Alon-Tal/WiFi-Alarm/Presentation/מצגת.pdf

# Wi-Fi אזעקת

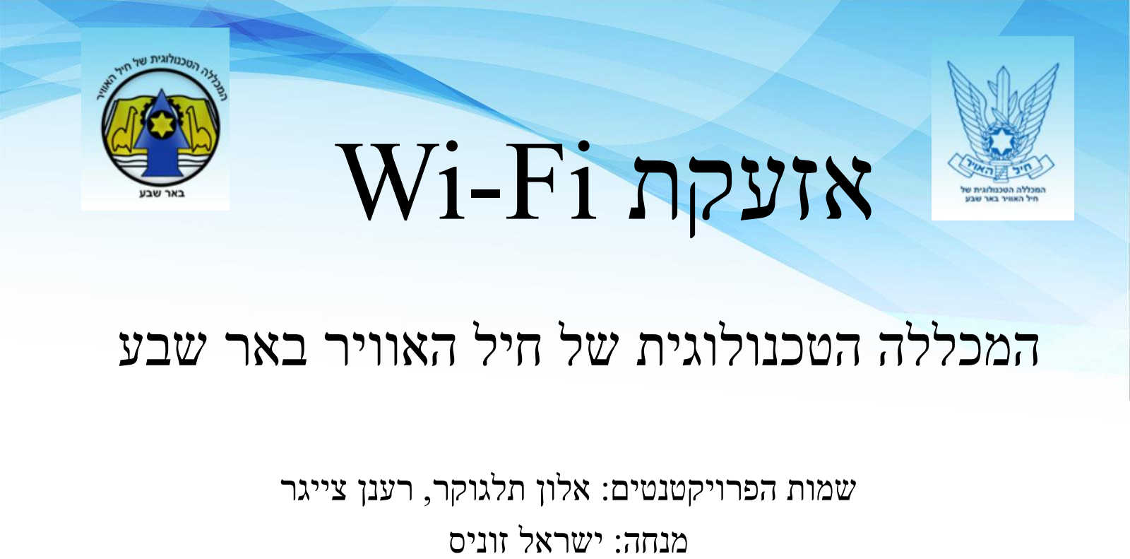
[picture p1: page 1]

שמות הפרויקטנטים: אלון תלגוקר, רענן צייגר מנחה: ישראל זוניס

# המכללה הטכנולוגית של חיל האוויר באר שבע

# תקציר:

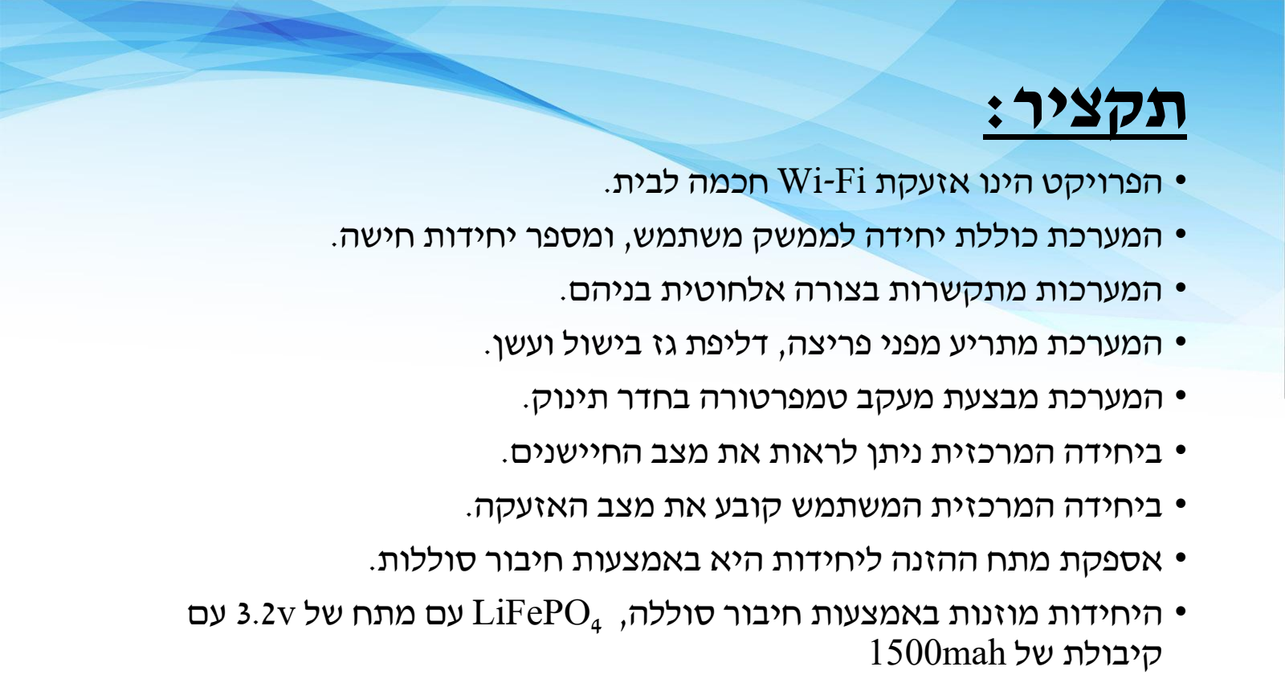
[picture p2: page 2]

- הפרויקט הינו אזעקת Fi-Wi חכמה לבית.
- המערכת כוללת יחידה לממשק משתמש, ומספר יחידות חישה.
- המערכות מתקשרות בצורה אלחוטית בניהם.
- המערכת מתריע מפני פריצה, דליפת גז בישול ועשן.
- המערכת מבצעת מעקב טמפרטורה בחדר תינוק.
- ביחידה המרכזית ניתן לראות את מצב החיישנים.
- ביחידה המרכזית המשתמש קובע את מצב האזעקה.
- אספקת מתח ההזנה ליחידות היא באמצעות חיבור סוללות.
- היחידות מוזנות באמצעות חיבור סוללה, LiFePO
4

עם מתח של v3.2 עם
קיבולת של mah1500

# דיאגרמת מלבנים של המערכת:

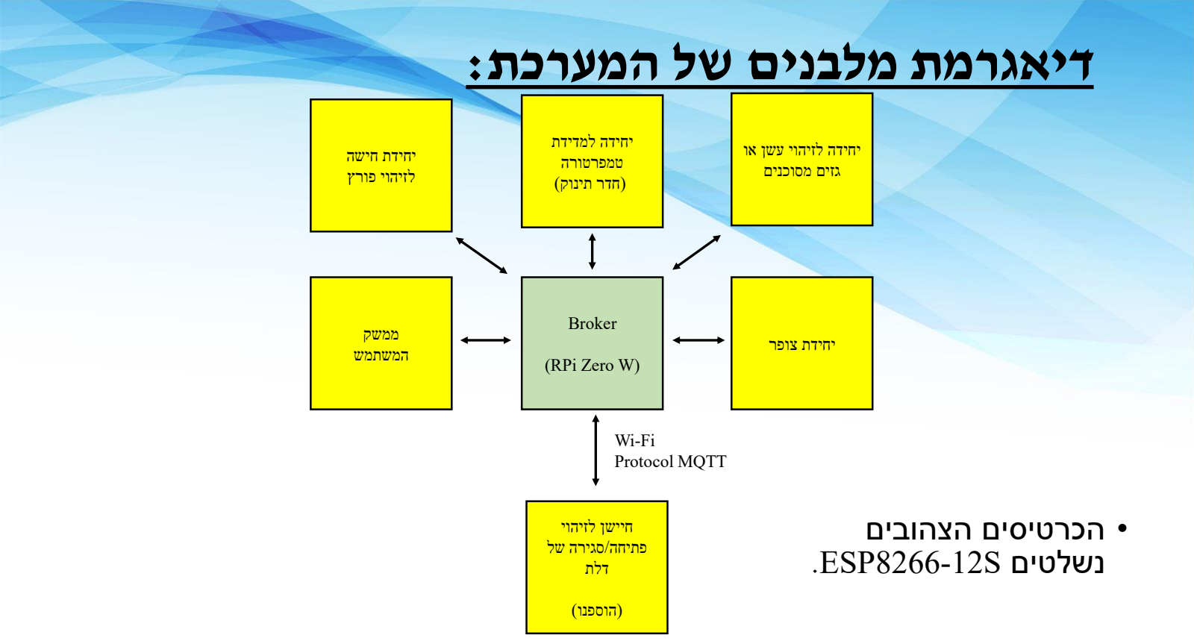
[picture p3: page 3]

- הכרטיסים הצהובים
.ESP8266-12S | נשלטים

יחידת חישה
לזיהוי פורץ

יחידה למדידת
טמפרטורה
)חדר תינוק(

יחידה לזיהוי עשן או
גזים מסוכנים

Broker

(RPi Zero W)

ממשק
המשתמש

יחידת צופר

חיישן לזיהוי
פתיחה/סגירה של
דלת

)הוספנו(

Wi-Fi
Protocol MQTT

## ממשק המשתמש-דיאגרמת בלוקים

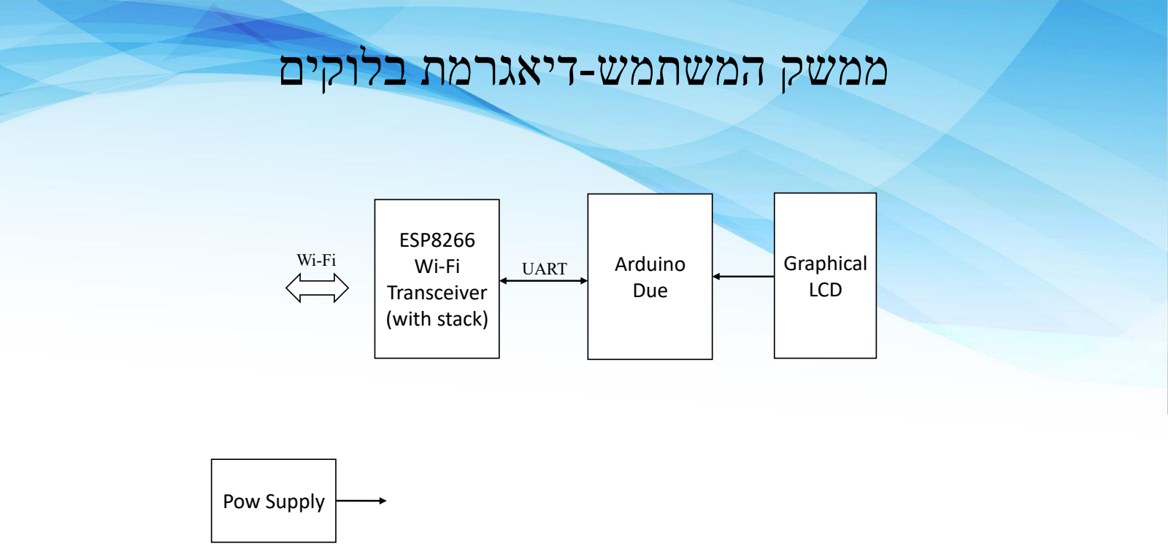
[picture p4: page 4]

Arduino
Due

Graphical
LCD

UART

ESP8266
Wi-Fi
Transceiver
(with stack)

Pow Supply

Wi-Fi

## יחידת חישה-דיאגרמת בלוקים

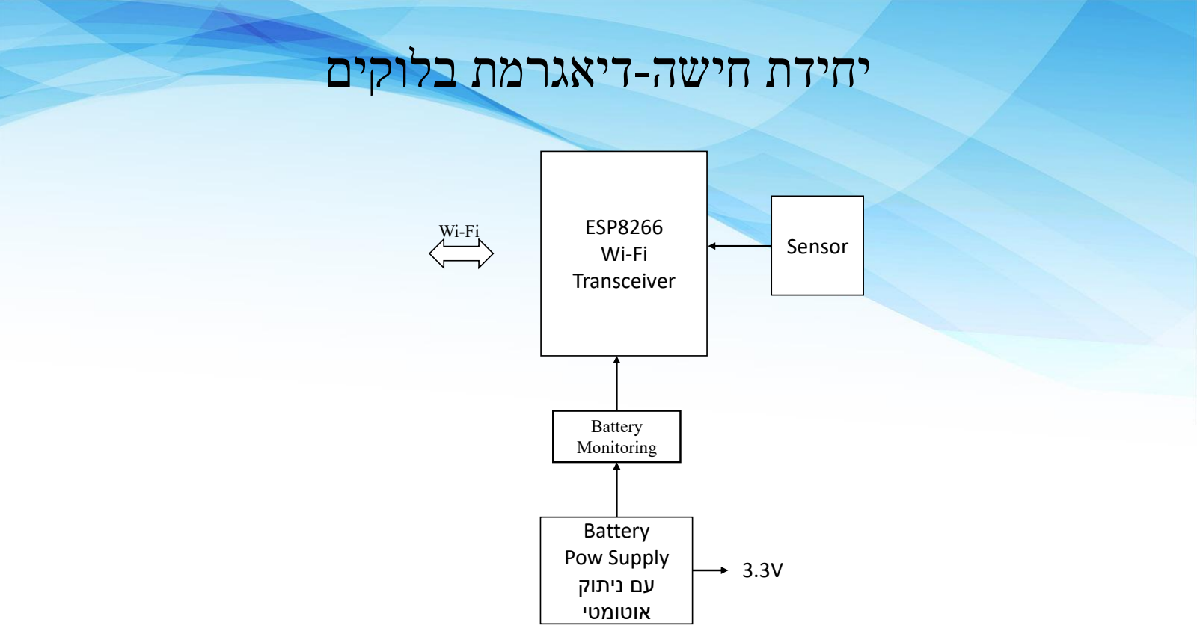
[picture p5: page 5]

3.3V

Sensor

ESP8266
Wi-Fi
Transceiver

Wi-Fi

Battery
Pow Supply
עם ניתוק
אוטומטי

Battery
Monitoring

# פרוטוקול MQTT:

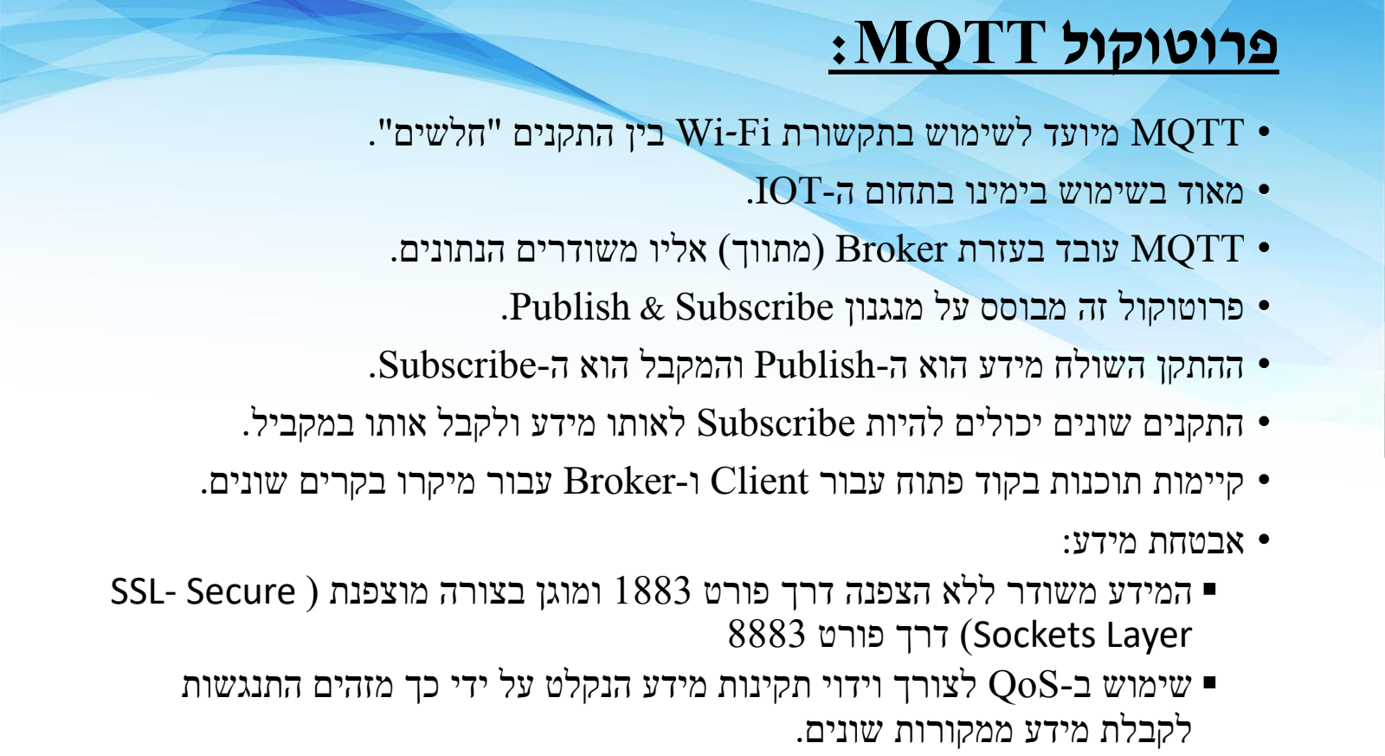
[picture p6: page 6]

- MQTT מיועד לשימוש בתקשורת Fi-Wi בין התקנים "חלשים".
- מאוד בשימוש בימינו בתחום ה-IOT.
- MQTT עובד בעזרת Broker( מתווך( אליו משודרים הנתונים.
- פרוטוקול זה מבוסס על מנגנון Subscribe & Publish.
- ההתקן השולח מידע הוא ה-Publish והמקבל הוא ה-Subscribe.
- התקנים שונים יכולים להיות Subscribe לאותו מידע ולקבל אותו במקביל.
- קיימות תוכנות בקוד פתוח עבור Client ו-Broker עבור מיקרו בקרים שונים.
- אבטחת מידע:
- המידע משודר ללא הצפנה דרך פורט 1883 ומוגן בצורה מוצפנת ) Secure -SSL Layer Sockets )דרך פורט 8883
- שימוש ב-QoS לצורך וידוי תקינות מידע הנקלט על ידי כך מזהים התנגשות לקבלת מידע ממקורות שונים.

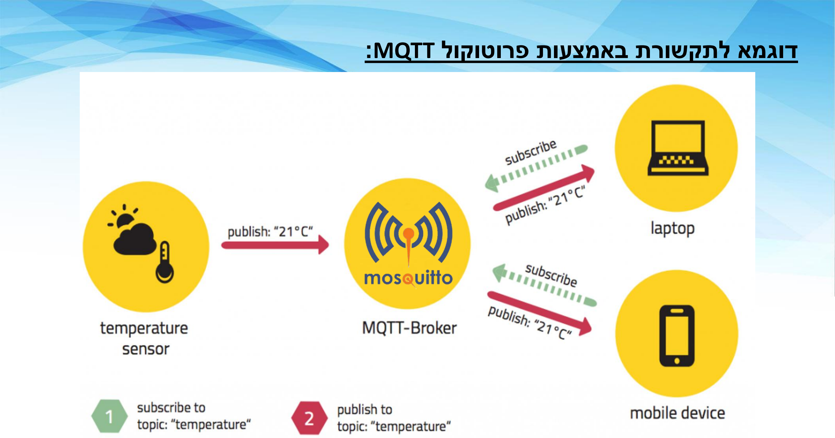
[picture p7: page 7]

דוגמא לתקשורת באמצעות פרוטוקול MQTT:

## :ESP8266 12-S בקר

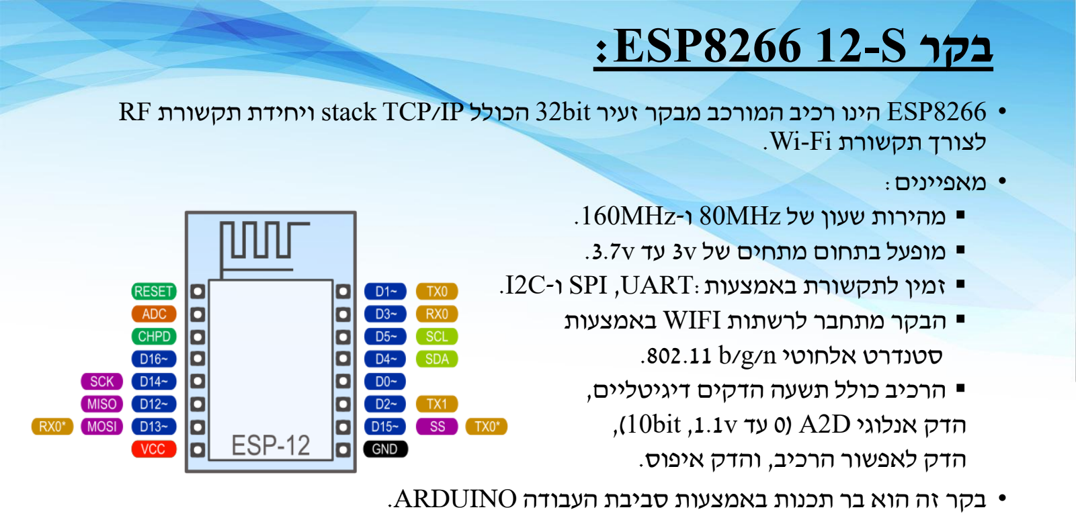
[picture p8: page 8]

- 8266ESP הינו רכיב המורכב מבקר זעיר bit32 הכולל IP/TCP stack ויחידת תקשורת RF לצורך תקשורת Fi-Wi.
- מאפיינים:
- מהירות שעון של MHz80 ו-MHz.160
- מופעל בתחום מתחים של v3 עד v.3.7
- זמין לתקשורת באמצעות:UART, SPI ו-C2I.
- הבקר מתחבר לרשתות WIFI באמצעות
.802.11 b/g/n | אלחוטי | סטנדרט
- הרכיב כולל תשעה הדקים דיגיטליים,
,)10bit ,1.1v עד 0 )A2D | אנלוגי | הדק
הדק לאפשור הרכיב, והדק איפוס.
- בקר זה הוא בר תכנות באמצעות סביבת העבודה ARDUINO.
