Alon-Tal/WiFi-Alarm/Book/ספר גרסא הסופית.pdf

# פרוייקט WiFi Alarm

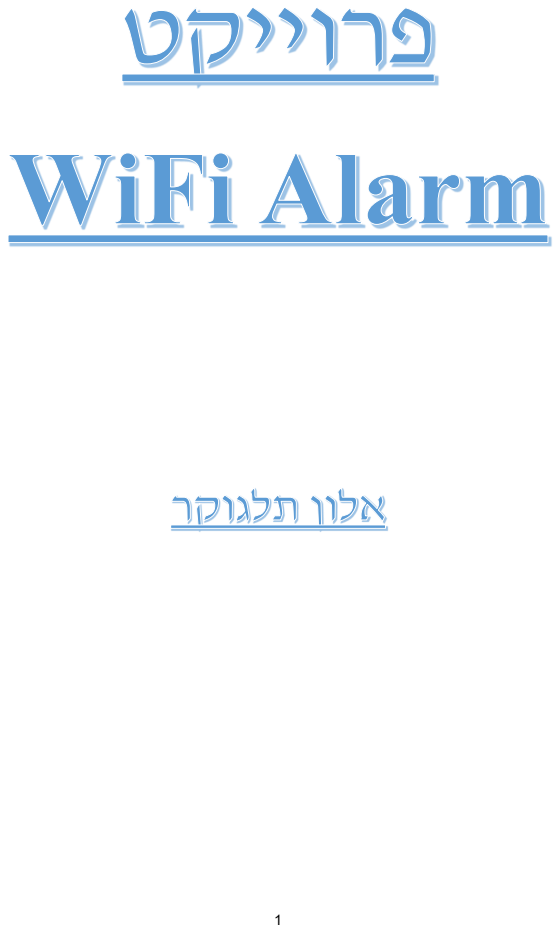
[picture p9: page 1]

### תקציר הפרויקט:

מטרת הפרויקט הינה תכנון ובניית אזעקה בעלת יכולות חישה רבות.

המערכת בנויה לפי מודל חדיש של מערכות אינטרנט של חפצים- IOT. היא כוללת יחידה לממשק עם המשתמש ומספר יחידות חישה. כל היחידות מקושרות בתקשורת Fi-Wi עם יחידה מרכזית.

המערכת מתריעה מפני פריצה לבית, דליפת גז בישול, דליפת עשן.

פונקציה נוספת של המערכת הינה מעקב טמפרטורה של חדר תינוק עם התראה מפני טמפרטורה גבוהה או נמוכה מידי המסכנת את התינוק.

כיוון שהעברת התקשורת בין היחידות מתבצעת באמצעות Fi-Wi אין צורך בהעברת כבלים בבית, יש רק לספק ליחידות מתח הזנה על ידי חיבור סולל ה מתאימה .

על ידי שימוש ביחידה המרכזית המשתמש יוכל לראות את מצב החיישנים ואחוזי הסוללות ובנוסף יוכל לקבוע את מצב י האזעקה.

זיהוי המשתמש היא על ידי תג זיהוי )RFID).

המערכת מתוכננת בצורה מודולארית וניתן להוסיף לה יחידות חישה נוספות בצורה יחסית קלה )יש רק להוסיף קוד מתאים ליחידת הממשק למשתמש(.

המערכת שולחת התראות לפלאפונים בעלי מערכת הפעלה Android.

תוכן עניינים -
פרק 1 מבוא 5 |
1.1 מבוא: 6 |
1.2 מפרט טכני: 7 |
1.3 רשימת מרכיבים: 8 |
1.4 הוראות הפעלה9 | :
פרק 2 דיאגרמת בלוקים 10 |
2.1 דיאגרמת בלוקים: 11 |
פרק 3 סכמה חשמלית 13 |
3.1 יחידת ממשק המשתמש 14 |
3.2 תרשים מלבנים עקרוני של יחידת החישה 17 |
פרק 4 תרשים זרימה 25 |
4.1 תרשים זרימה של התוכנית הראשית ביחידת ממשק המשתמש26 | :
4.2 תרשים זרימה של התוכנית ב8266-ESP ביחידת ממשק המשתמש35 | :
4.3 תרשים זרימה של התוכנית ב8266-ESP ביחידות החישה37 | :
פרק 5 תוכנה 39 |
5.1 התוכנה שצרובה ליחידת ממשק המשתמש: 40 |
טבלת פונקציות43 | :
5.2 התוכנית שצרובה ל 8266-ESP ביחידת ממשק המשתמש47 | :
טבלת פונקציות48 | :
5.3 התוכנה שצרובה ל- 8266esp שמחובר לחיישן גז: 49 |
טבלת פונקציות50 | :
פרק 6 זיווד 51 |
פרק 7 סיכום 54 |
7.1 פרק תקלות במהלך העבודה55 | :
7.2 פרק סיכום והסקת מסקנות: 55 |
הצעות לפיתוח עתידי: 55 |
פרק 8 ביבליוגרפיה 56 |
פרק 9 נספחים 58 |
59 | :Arduino Due 9.1
9.2 תצוגה גרפית עם מסך מגע60 | :
9.3 צופר BUZZER: 61 |
9.4 שעון זמן אמת 1302DS RTC: 62 |
9.5 חיישן זיהוי צ'יפים RFID: 63 |
65 | :ESP8266-12S | בקר | 9.6
66 | :AT24C64 (EEPROM ( | זיכרון | יחידת | 9.7
9.8 גלאי גז בישול 6MQ וגלאי עשן 135MQ: 68 |
9.9 סוללות 4LiFePO69 | :
9.10 ממיר מתח ממותג )Up Step (BOOST70 | :
9.11 חיישן טמפרטורה 20B18DS71 | :
9.12 פרוטוקול תקשורת WIRE-ONE: 73 |
9.13 פרוטוקול SPI76 | :
78 | :I2C | פרוטוקול | 9.14
9.15 פרוטוקול UART81 | :
9.16 פרוטוקול MQTT: 83 |
פרק חישובים: 93 |

רשימת טבלאות:

טבלה 1 - טבלת החיבורים של ה-DUE ARDUINO16 | :
טבלה 2 - טבלת החיבורים של בקר ה8266-ESP 19 |
טבלה 3 - טבלת הפונקציות בתוכנית ביחידת ממשק המשתמש43 |
טבלה 4 - טבלת פונקציות של ה8266-ESP ביחידת ממשק המשתמש 48 |
טבלה 5 - טבלת פונקציות של אחת מיחידות החישה 50 |

רשימת איורים:

איור 1 - דיאגרמת מלבנים של הפרוייקט 11 |
איור 2 - דיאגרמת בלוקים של יחידת ממשק המשתמש 14 |
איור 3 - סכמה חשמלית של יחידת ממשק המשתמש 15 |
איור 4 - דיאגרמת בלוקים של יחידת החישה 17 |
איור 5 - תרשים חשמלי של חיישני הגז והעשן 18 |
איור 6 - תרשים חשמלי עקרוני של החיישנים הדיגיטליים. 21 |
איור 7 - תרשים חשמלי של ה-Supply Power23 |
איור 8 - ממשק למשתמש 52 |
איור 9 - חיישני החישה 53 |
59 | Arduino Due -10 איור
איור 11 - תצוגה גרפית 60 |
איור 12 - תיאור של מסך התנגדותי 60 |
איור 13 - יחידת הצופר 61 |
62 | RTC DS1302 - 14 איור
איור 15 - קורא צ'יפים וצ'יפ63 |
איור 16 - 8266ESP65 |
איור 17 - יחידת הזיכרון 66 |
איור -18 חיישן גז וחיישן עשן 68 |
איור 19 - סוללות 69 |
איור 20 - ממיר מתח ממותג70 |
איור 21 - חיישן טמפרטורה 71 |
איור 22 - תיאור תדרי הגביש72 |
איור 23 - 20B18DS אופן שידור 73 |
איור 24 - חיבור רכיבים בתקשורת SPI 76 |
איור 25 - שידור 56x0 בתקשורת טורית 82 |
איור 26 - מבנה עקרוני של תקשורת 84 |
איור 27 - מודל 4 השכבות 85 |
איור 28 - תיאור חיבור אל ה-Broker 86 |
איור 29 - תיאור הנושאים 87 |
איור 31 - איכות שירות 1 90 |
איור 32 - איכות שירות 2 91 |
איור 33 - שרטוט השמיט ממעגל המיתוג האלקטרוני שבאיור 93 | 3.6
איור 34 - רוחב החשל 93 |

# פרק 1 מבוא

### 1.1 מבוא:

בפרויקט זה תכננו ובנינו מערכת אזעקה לבית. המערכת תתריע מפני פריצה לבית, דליפת גז בישול, גילוי שריפה, ותציג את הטמפרטורה בחדר נבחר.
המערכת מורכבת ממספר כרטיסים: כרטיס ממשק משתמש, וכרטיסי חישה וצופר. בין הכרטיסים מתקיימת תקשורת Fi-Wi לפי מודל הנפוץ במערכות IOT ( Internet Things Of). לפי מודל זה המערכת מורכבת מיחידות שונות שמתקשרות עם היחידה המרכזית המכונה Broker. היחידות השונות יכולות לשלוח מידע ל-Broker )Publisher )או להירשם לצורך קבלת נתונים מה -Broker( Subscribe). בין היחידות תקשורת לפי פרוטוקול MQTT( מוסבר בנספח( פרוטוקול זה נפוץ יותר מפרוטוקול HTTP במערכות IOT ובמערכות מנוהלות באמצעות מיקרובקרים "חלשים".
ה-Broker ממומש באמצעות כרטיס W-Zero Pi Raspberry בעל מערכת הפעלה Raspbian-Linux ומריץ תוכנה Mosquitto Eclipse שהיא תוכנת Broker בקוד פתוח.
כל שאר הכרטיסים נשלטים באמצעות כרטיס מיקרו בקר S8266-12ESP. זהו

מיקרו בקר בעל 32 סיביות, ובעל ליבה לתקשורת Fi-Wi כולל Stack IP/TCP. יחידת הממשק למשתמש כוללת צג מגע שנותנת למשתמש אפשרות נוחה ל הקליד הוראות הפעלה ולראות את המידע של החיישנים השונים שבבית. כרטיסי יחידת החישה מזהים שינוי קריטי באחד מהחיישנים בבית ומפעילה צופר. המערכת שולחת התראות לפלאפונים בעלי מערכת הפעלה Android.

### 1.2 מפרט טכני:

- אזעקה לבית חכם
- גילוי פריצה לדירה על ידי שימוש בחיישן נפח ופתיחת דלת.
- גילוי עשן בדירה, גילוי דליפת גז בישול.
- התראה מפני טמפרטורה גבוהה או נמוכה בחדר תינוק.
- תכנון אזעקה באמצעות מסך מגע.
- תקשורת Fi-Wi( פרוטוקול MQTT )בין היחידות השונות.
- כל אחת מהיחידות מוזנת מסוללת ליתיום דור חדש )4LiFePO), זמן בין הטעינות מותנה בקיבול הסוללה ) mah).

### 1.3 רשימת מרכיבים:

AT91SAM3X8E | בקר | מיקרו | בתוכו | הכוללת | ARDUINO DUE | כרטיס | •
ESP8266-12S | בקר | •
- חיישן עשן 135MQ
- חיישן גז בישול 6MQ
AT24c64 EEPROM | זיכרון | •
- חיישן תנועה 501SR-HC
CD74HC4053 | בורר | •
- חיישן טמפרטורה 20B18DS
- צ'יפים + חיישן קליטת צ'יפ RFID
RTC DS1302 | שעון | •
- מייצב 9193-28RT
AO3401 MOSFET | טרנזיסטור | •
- מגברי שרת 324LMV כחוצץ ושמיט
SPI TFT LCD 2.8'' מגע | מסך | •
LiFePO4 3.2v | סוללות | •
DC-DC Boost Converter Step Up 5v | מתח | מגביר | •
1Kohm Passive Buzzer Electromagnetic Alarm | צופר | •

### 1.4 הוראות הפעלה:

יש לחבר אל כל יחידות החישה סוללות של 4LiFePO ליחידות החיישני גז בישול והעשן 2 סוללות ולשאר יחידות החישה סוללה אחת. אל יחידת ממשק המשתמש יש לחבר ליחידת ממשק המשתמש סוללה של v.9 את ה כרטיס -Zero Pi Raspberry W יש לחבר לחשמל או לסוללה ניידת של v5 עם מינימום זרם של mA500( עדיפות לזרם של A2).

בדוק כי על יחידת ממשק המשתמש קיבלת ערכים של החיישנים ושל אחוזי הסוללה.

במידה ולא קיבלת שום ערך בדוק כי ישנה נקודת גישה של Fi-Wi עם שם המשתמש והסיסמא שהוגדר ביחידות חישה.

במידה וזו לא הבעיה בדוק כי W-Zero Pi Raspberry מחובר אל נקודת הגישה.

במידה וקיבלת רק חלק מהערכים של החיישנים על התצוגה החלף סוללה ליחידות שלא מגיבות וחכה לערך על המסך.

# פרק 2 דיאגרמת בלוקים

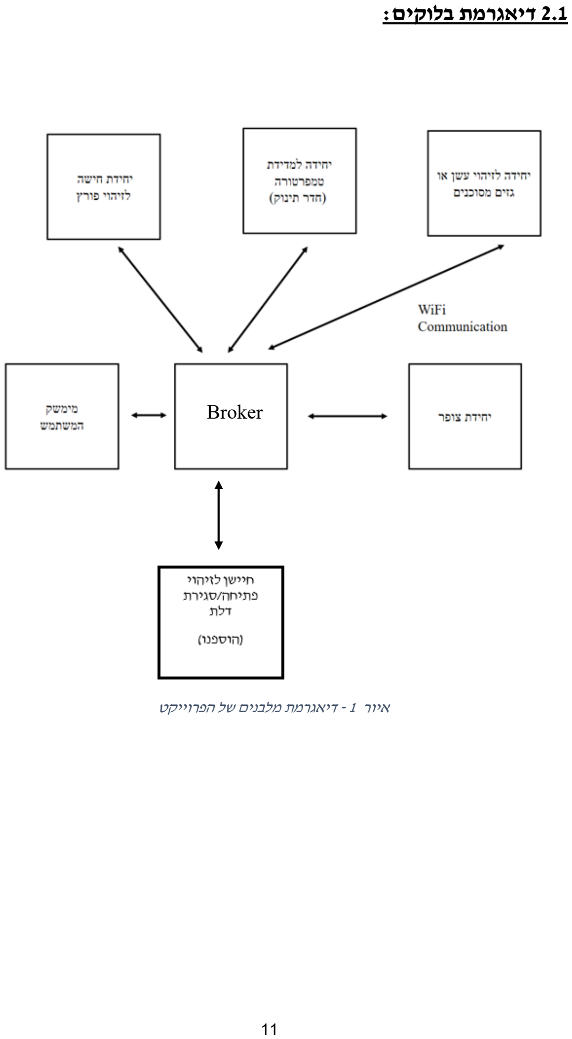
[picture p10: page 11]

איור 1 - דיאגרמת מלבנים של הפרוייקט

### 2.1 דיאגרמת בלוקים:

Broker

במבוא של ספר הפרויקט יצגנו שהפרויקט בנוי ממספר יחידות שבניהם מתקיימת תקשורת Fi-Wi, הדיאגרמה הכללית של הפרויקט מתוארת באיור 2.1 ובה רואים את היחידות השונות של הפרויקט. השימוש בתקשורת אלחוטית משחררת מהצורך במשיכת כבלים בין היחידות השונות שממנה מורכבת מערכת האזעקה.

Broker- זו היחידה המרכזית שאחראית על קבלת המידע ושליחת המידע בין היחידות השונות. תחילה השתמשנו בתוכנת Broker ברשת ב -Online של Adafruit וקצת קיבלנו רקע על הנושא, לאחר מכן עברנו למחשב בעל מערכת הפעלה של Windows מפני שנקודת הגישה הייתה לא איכותית עד כדי שהתקשורת נקטעה. לבסוף החלטנו להשתמש ב-W-Zero Pi Raspberry מפני גודלו הקטן עלותו הנמוכה וצריכת זרם נמוכה.

ממשק למשתמש: באמצעות יחידה זו המשתמש שולט על אופן הפעולה של היחידות השונות של האזעקה וגם יכול לקבל מידע ומשוב מהיחידות. יחידה זו מאפשרת למשתמש לשלוט על מצבי האזעקה בבית. כיוון שהשתמשנו בפלאפון כ- -Wi Router Fi היינו מוגבלים לשמונה יחידות קצה, לא בנינו כרטיס נפרד ליחידת הצופר אלא חיברנו אותו ליחידה זו.

יחידה לזיהוי עשן וגזים מסוכנים: יחידה זו נועדה ליי דע את המשתמש מפני דליפה של גז בישול ועשן המעיד על דליקה בבית. לשם כל השתמשנו בחיישן 6MQ אשר

מזהה דליפה של גז בישול, ו135-MQ המזהה עשן בבית.

יחידה למדידת טמפרטורה: כיוון שתינוקות רגישים לטמפרטורות נמוכות או גבוהות החלטנו להוסיף למערכת האזעקה יחידה לניטור הטמפרטורה בחדר התינוק ותפקידה לתת התראה שהטמפרטורה חורגת מתחום הערכים שתינוק רגיש להם. כחיישן טמפרטורה השתמשנו ברכיב 20B18DS בעלת דיוק של חצי מעלה.

יחידת חישה לזיהוי פורץ: יחידה זו נועדה לידע את המשתמש מפני תנועה לא מוכרת בבית. לשם כך השתמשנו בחיישן נפח שמשמש לזיהוי תנועה 501-SR-HC.

יחידה לזיהוי פתיחה/סגירת דלת :יחידה זו נועדה לידע את המשתמש על מצבה של הדלת. לשם כך השתמשנו במפסק מאולתר המורכב מחוט מוליך אשר מתקצר כאשר הדלת סגורה ומתנתק כאשר הדלת פתוחה.

# פרק 3 סכמה חשמלית

### 3.1 יחידת ממשק המשתמש

המבנה הכללי של יחידה זו מתואר באיור 3.1 והסכימה החשמלית באיור .3.2 יחידה זו מורכבת מכרטיס בקר זעיר Due Arduino שאחראי על הפעלת המרכיבים השונים של יחידה זו, כרטיס 8266ESP שתפקידו ביצוע תקשורת Fi-Wi, תצוגת LCD גרפית עם ממשק מגע, צופר )מעשית השתמשנו בזמזם על מנת להקטין את הרעש(, וסוללת V.9

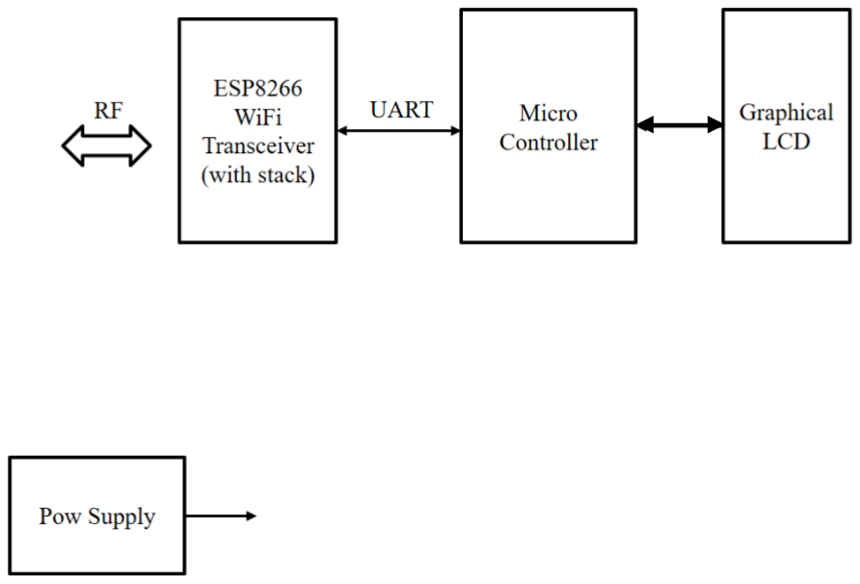
[picture p11: figure]

איור 2 - דיאגרמת בלוקים של יחידת ממשק המשתמש

החיבורים מתוארים בטבלה .3.1 יש לציין שהחיבור בין המיקרובקר Due Arduino לבין המסך LCD כולל יחידת המגע הינו חיבור אות טורי לפי פרוטוקול SPI שהוא פרוטוקול סינכרוני לכן חיבור זה דורש ארבע חוטים:
(Master In Slave Out) MISO -(Master Out Slave In) MOSI -SCK -
- אפשור: הדק CS של ה- LCD, הדק CS_T של משטח המגע, הדק SDA של ה-RFID.
ל-Due Arduino מספקים מתח של v,9 על הכרטיס ישנו מיצב מתח מסוג 1117-3.3LM שממיר את המתח ל -v.3.3 מתח זה מחובר להדק של הכרטיס ואנו משתמשים בו להפעלת שאר כרטיסי המערכת.

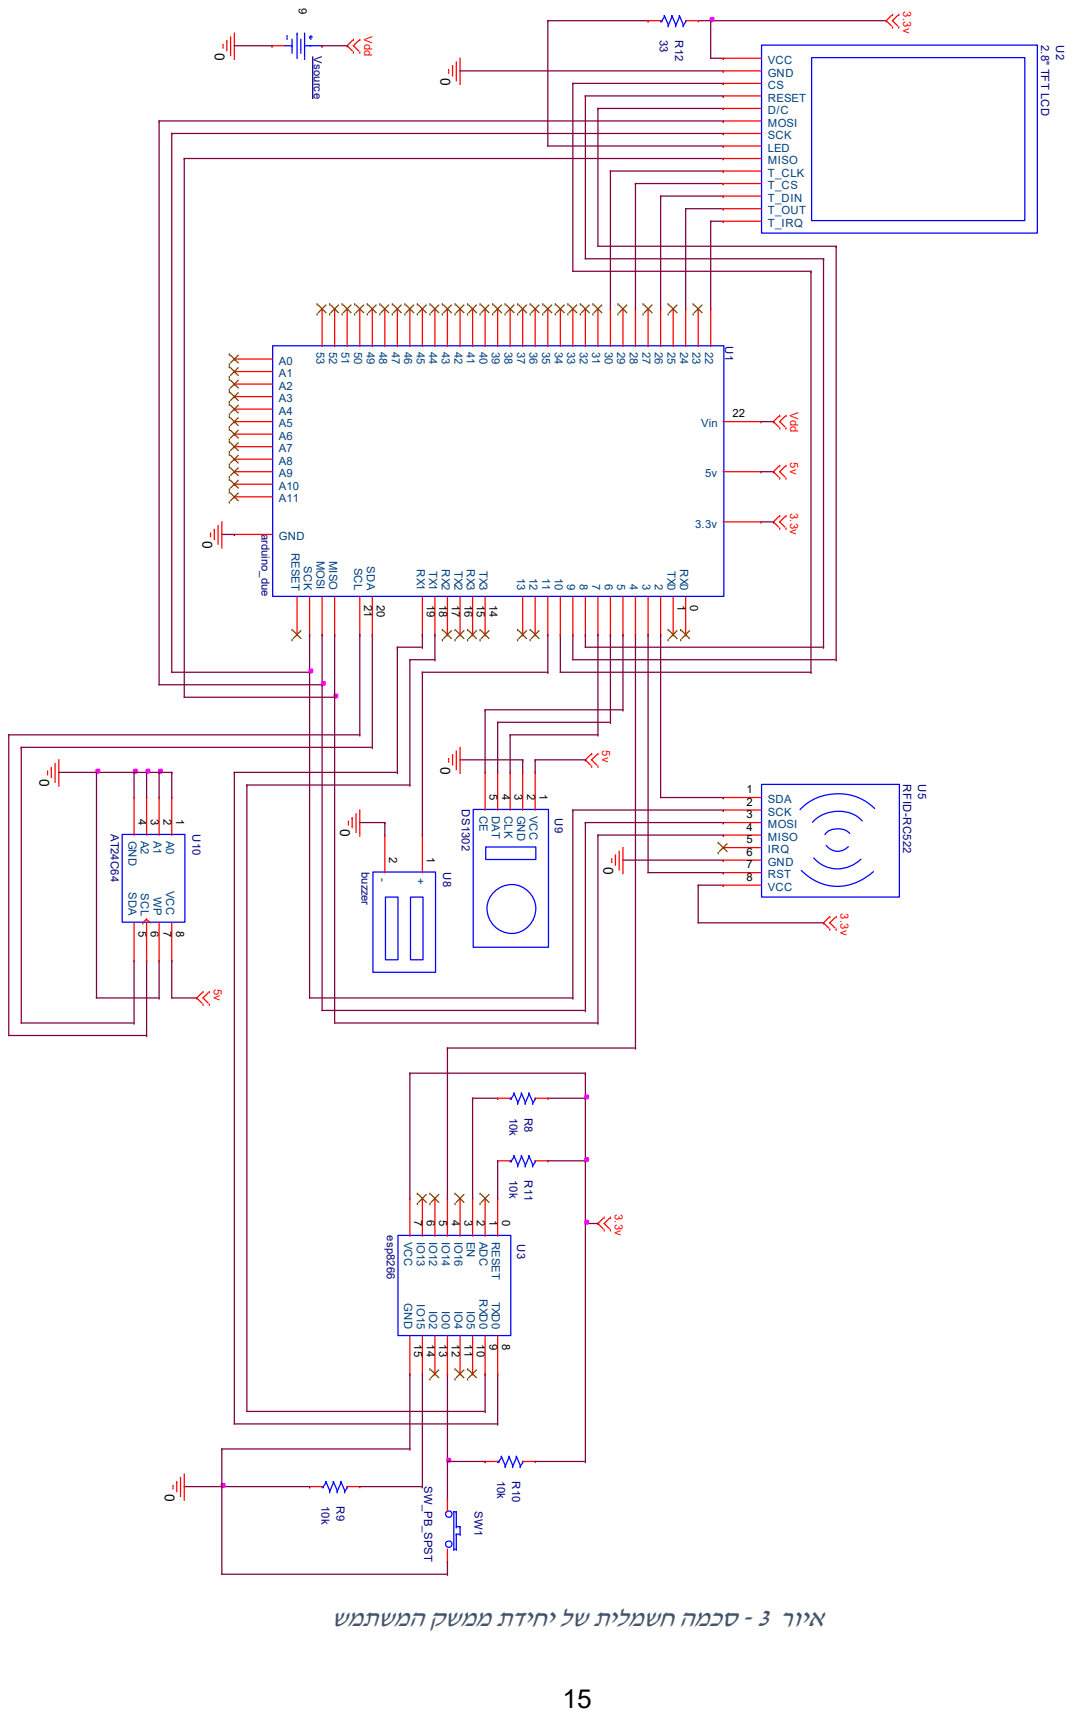
[picture p12: page 15]

איור 3 - סכמה חשמלית של יחידת ממשק המשתמש

טבלה 1 - טבלת החיבורים של ה-DUE ARDUINO:
| | | הדקים שם ה-SIGNAL הסבר לאן מחובר בפרויקט
תצוגה גרפית | הדקים דיגיטליים | D8 D9 D10 | 8 9 10
מסך מגע | הדקים דיגיטליים | D22 D24 D26 D28 D30 | 22 24 26 28 30
תצוגה גרפית חיישן מזהה צ'יפים RFID | תקשורת SPI | ICSP ICSP ICSP | MOSI MISO SCK
חיישן מזהה צ'יפים RFID | הדקים דיגיטליים | D2 D3 | 2 3
ESP8266-12S | | | 4 4D הדק דיגיטלי בקר
| תקשורת UART1 | TX1 RX1 | 18 19
שעון DS1302 | הדקים דיגיטליים | D5 D6 D7 | 5 6 7
| | | 11 11D הדק דיגיטלי צופר
זיכרון AT24C64 EEPROM | תקשורת I2C | SDA SCL | 20 21

### 3.2 תרשים מלבנים עקרוני של יחידת החישה

לכל אחד מיחידות החישה שבפרויקט מבנה דומה לכן לא אתאר כל אחת מהיחידות בנפרד. המבנה מתואר באיור 3.3 והסכימה החשמלית באיור .3.4 יחידה זו מורכבת מכרטיס בקר זעיר 8266ESP שאחראי על הפעלת המרכיבים השונים של יחידה זו וגם אחראי על ביצוע תקשורת Fi-Wi הכולל שליחת מידע אודות החיישן והסוללה.

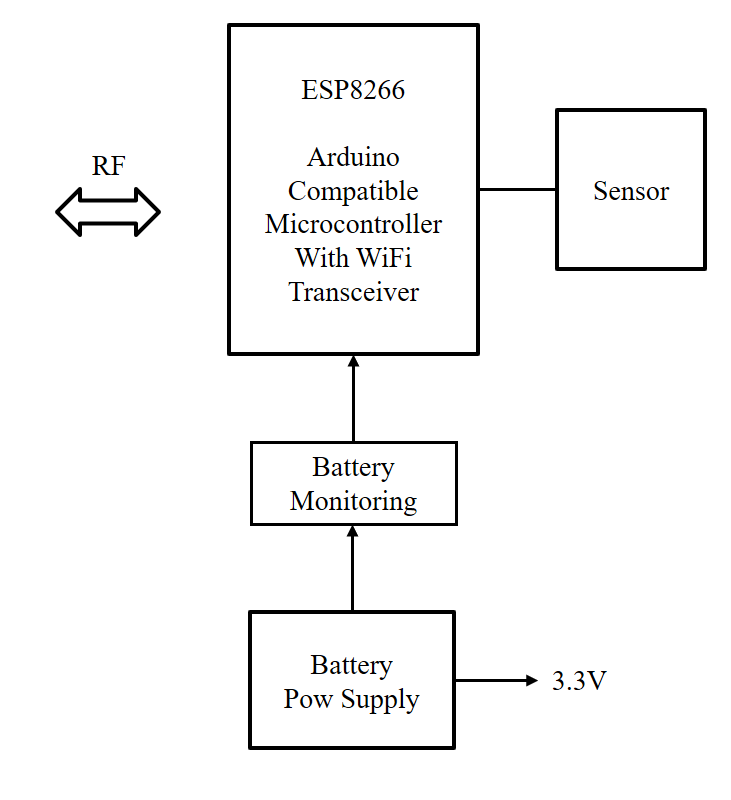
[picture p13: figure]

איור 4 - דיאגרמת בלוקים של יחידת החישה

סכמה מלבנים זו מתארת את אופן פעולת יחידת החישה. בפרויקט שלנו קיימות שישה יחידות של חיישנים הכוללות: 2 חיישני תנועה, חיישן עשן , חיישן גז בישול, חיישן טמפרטורה, וחיישן לגילוי מצב הדלת. מידע החיישן ואחוזי הסוללה משודרים בצורה אלחוטית בעזרת בקר 8266ESP אל יחידת ממשק המשתמש, ובכך המשתמש יכול לקבל מידע על המערכת כולה.

עקב כפילות הסכימה החשמלית של חיישני הגז הוספנו רק תרשים אחד ששיי ך עקרונית לשניהם

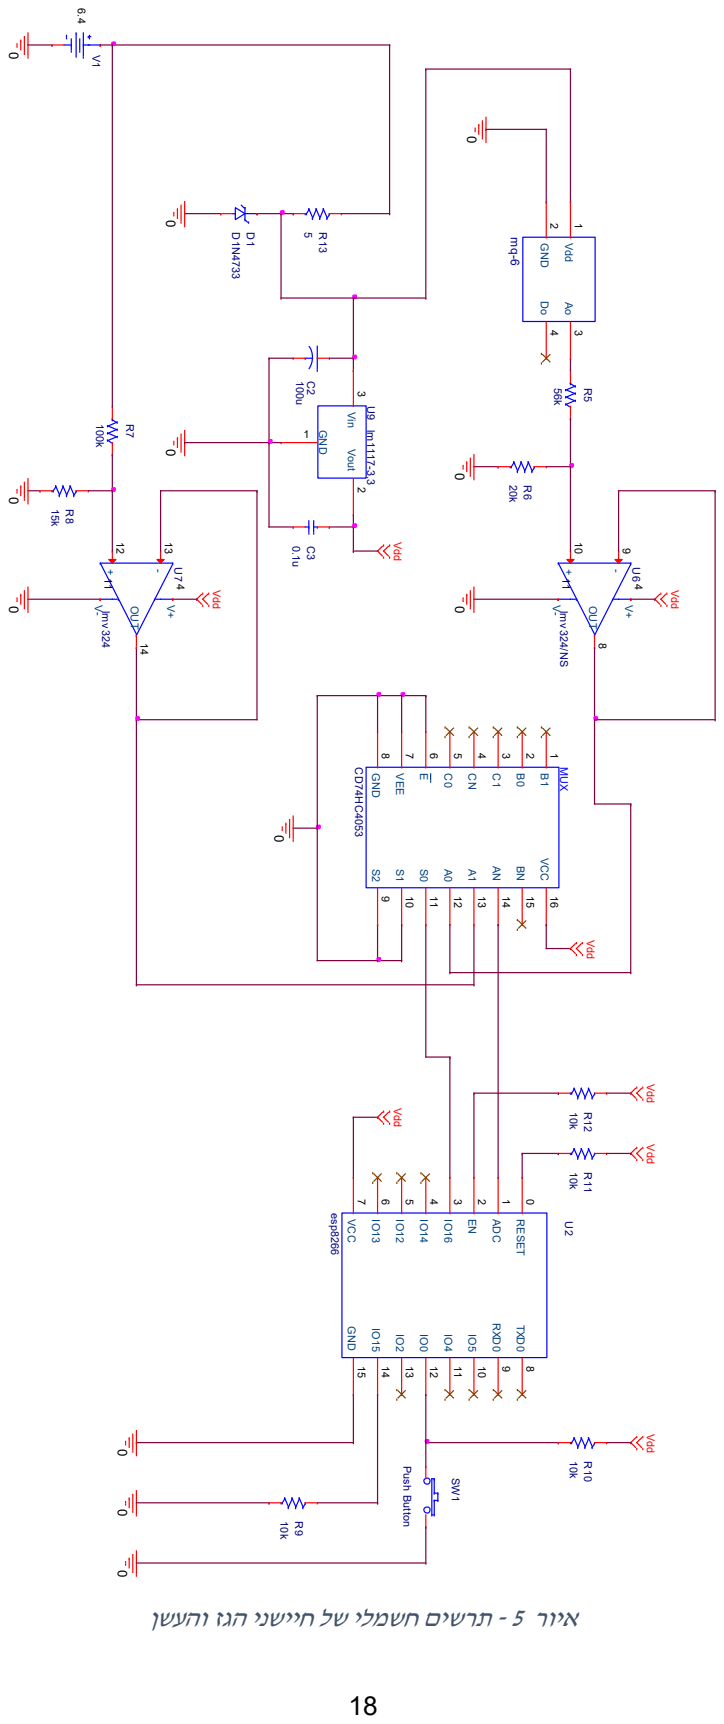
[picture p14: page 18]

איור 5 - תרשים חשמלי של חיישני הגז והעשן

הסבר תרשים חשמלי:

בעזרת זנר ייצבנו את המתח ל -v5 בשביל החיישני גז, ואת הנגד 13R בחרנו כדי שיזרום דרכו זרם שיספיק גם לזנר וגם לשאר העומס של המעגל.

לשאר המעגל אנחנו השתמשנו ב- 1117-3.3lm שמנחית מתח מ -v5 ל- v3.3 .

מתח הסוללה ומתח החיישנים מגיעים למחלק מתח שנועד להקטין את המתח ביחס קבוע כדי שה- 8266ESP יוכל למדוד את הערכים הללו.

החוצצים נועדו בכדי למנוע מהתנגדו יות של הרכיבים הבאים שמחוברים לא לפגוע בערך מחלק המתח.

מפני של- 8266ESP יש רק הדק אנ לוגי אחד בחרנו במוקס, ובעצם נכניס כל פעם אות אחר על פי איך שנגדיר את הדקי הבקרה של המוקס.

*מכיוון שרכיב זה קיים בפרויקט בכל אחת מהמערכות, אנו נתייחס לכל הדק ברכיב זה, ולאן היא מחוברת בכל אחת מהמערכות.

טבלה 2 - טבלת החיבורים של בקר ה8266-ESP
| הסבר לאן מחובר בפרויקט | SIGNAL | הדק שם ה-
התנגדות של K,10 אל מתח של v3.3 מסוללה. תקף בכל המערכות. | | | 0 RESET הדק איפוס מחובר דרך נגד UP-PULL בעל
מערכת חיישן גז בישול 6MQ ומערכת חיישן עשן ו135MQ: מחובר לבורר 4053HC74CD להדק AN. במערכות: חיישני תנועה , חיישן טמפרטורה 20b18DS, גלאי סגירה ופתיחת דלת: מחובר למחלק מתח הנועד למדוד את מתח הסוללה. | | | 1 ADC הדק אנאלוגי הדק זה מחובר:

התנגדות של K,10 אל מתח של v3.3 מסוללה. תקף בכל המערכות. | | 2 EN הדק אפשור הרכיב מחובר דרך נגד UP-PULL בעל
מערכת חיישן גז בישול 6MQ ומערכת חיישן עשן ו135MQ: מחובר לבורר 4053HC74CD להדק 0S. במערכות: חיישני תנועה 7PIR, חיישן טמפרטורה 20b18DS, גלאי סגירה ופתיחת דלת: מחובר ישירות למוצאי החיישנים. | | 3 16IO הדק דיגיטלי הדק זה מחובר:
| | 7 VCC מתח הזנה v,3.3 תקף בכל המערכות.
הדק זה מחובר דרך ג'אמפר אל האדמה. תקף בכל המערכות. | לאפשור צריבה | 12 0IO הדק דיגיטלי,
הדק זה מחובר דרך מוליך אל האדמה. תקף אך ורק במערכת גלאי סגירה ופתיחת דלת | נועד לגילוי פתיחה/סגירת דלת | 10 5IO הדק דיגיטלי,
DOWN תקף בכל המערכות. | | 14 15IO אפשור RESET מחובר לאדמה דרך נגד PULL
| | 15 GND אדמה אדמה, תקף בכל המערכות.

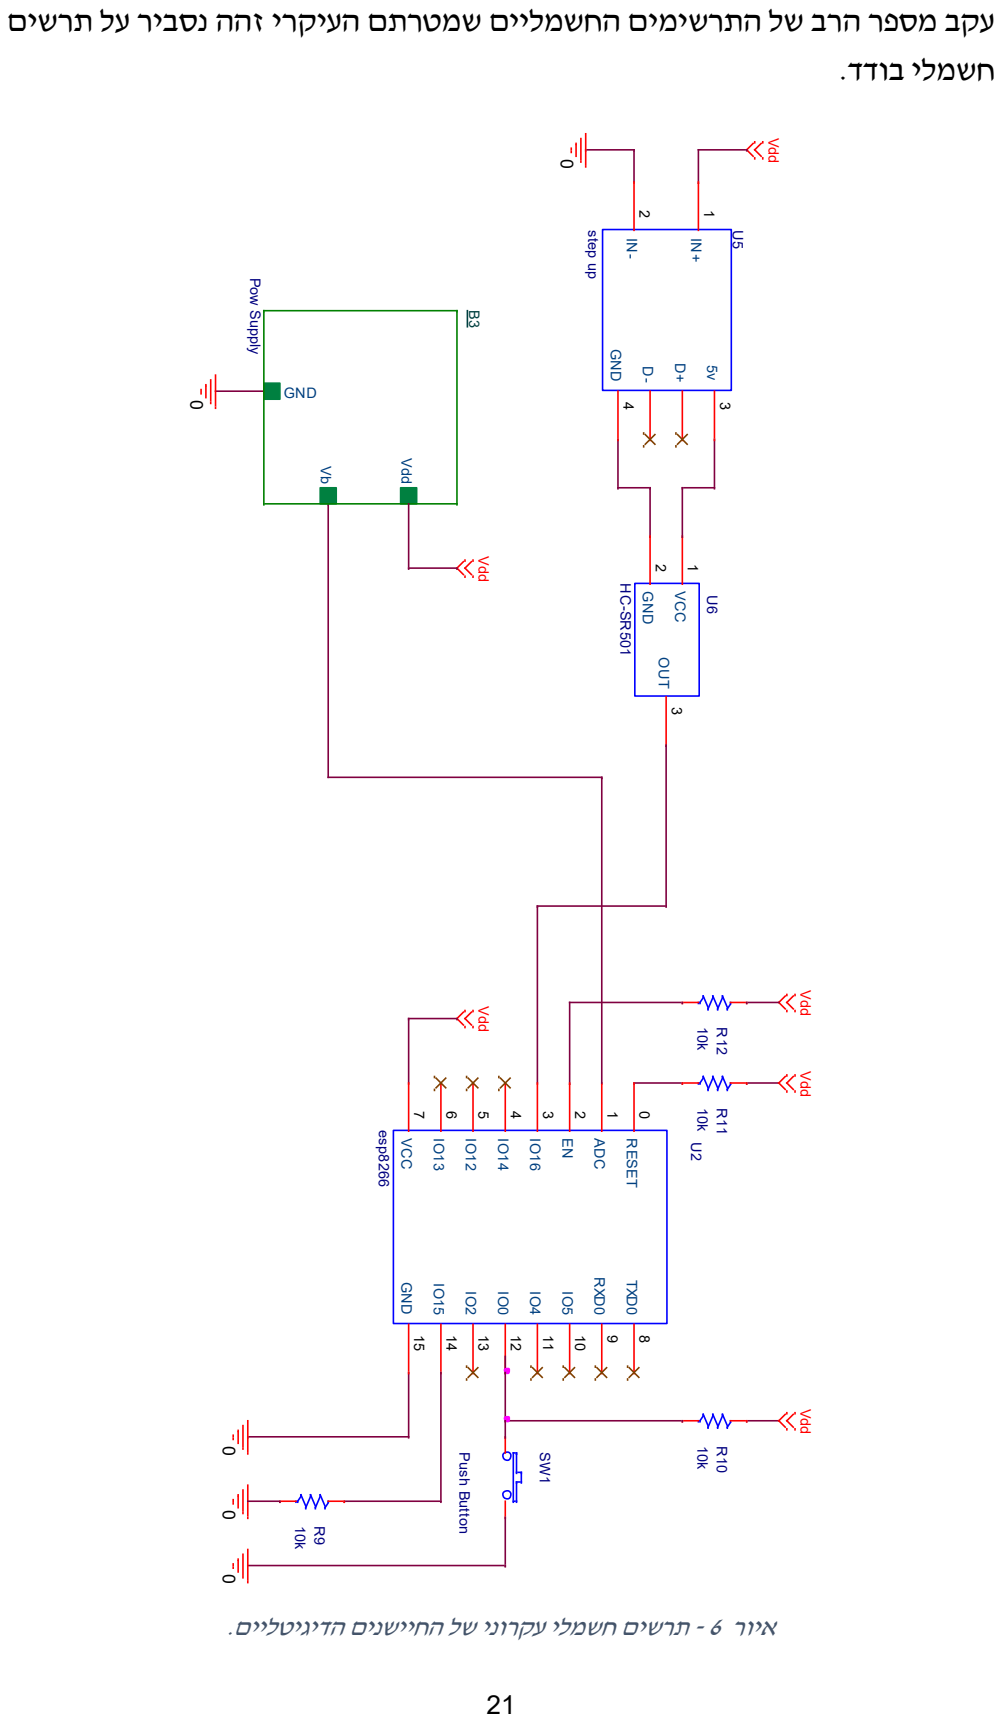
[picture p15: page 21]

עקב מספר הרב של התרשימים החשמליים שמטרתם העיקרי זהה נסביר על תרשים

איור 6 - תרשים חשמלי עקרוני של החיישנים הדיגיטליים.

ה8266esp הינו הרכיב שמחבר בין רכיבי המעגל. רכיבים כמו החיישן נפח שצורכים מתח הזנה של v5 מחוברים אל ה- up step. מוצא החיישן נפח מפיק מתח של v3.3 כאשר ישנה תנועה. וכאשר אינו מזהה תנועה אז מתח של v0 לכן הדק זה מחובר לפין דיגיטלי של ה- 8266ESP. המתג המאולתר של גילוי מצב הדלת גם עובד על אותו עיקרון כאשר הדלת סגורה היא תקצר בין 2 הדקים לכן גם חיישן זה יחובר להדק דיגיטלי. החיישן טמפרטורה הוא חיישן ספרתי המעביר מידע דרך wire1-( הסבר פרוטוקול בנספחים(. לכן הדק זה גם יחובר להדק דיגיטלי. ה 8266-ESP קורא את המידע שנותנים החיישנים ושולח את המידע אל המערכת המרכזית. ליחידות אלו המתח מתקבל ממייצב מתח שמתואר באיור .3.6

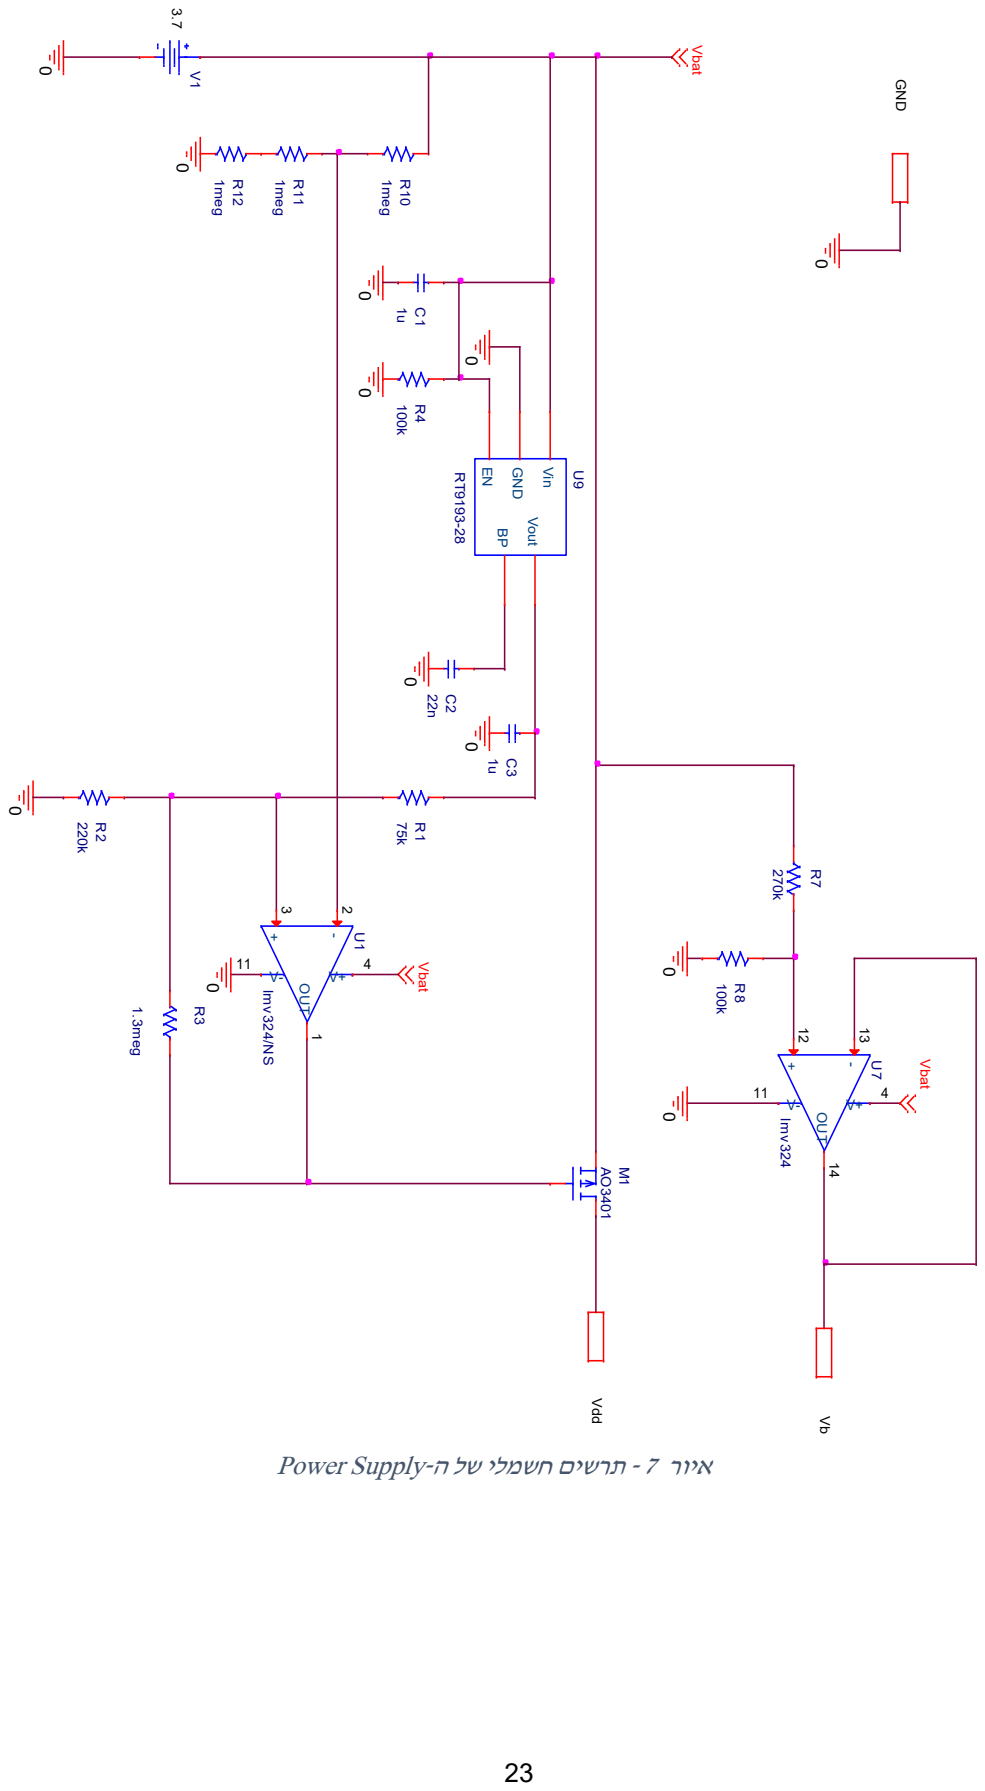
[picture p16: page 23]

איור 7 - תרשים חשמלי של ה- Supply Power

עקב החיסרון של הסוללות במידה ויתפרקו מתחת למתח של v2.8 אז הסוללה עלולה להיהרס לכן בחרנו לבחור ולבנות מתג אלקטרוני. בחרנו בשמיט מפני רוחב החשל שלא תהיה השוואה עם ערך מתח אחד.

מעגל זה נועד למיתוג הסוללה עם המעגלים החשמליים, כאשר מתח הסוללה נמוך המעגל לא יקבל את מתח הסוללה וכאשר הסוללה טעונה המעגל יקבל את מתח הסוללה. לשם כך אנחנו משתמשים ב- Channel-P MOSFET הדק ה-Source מחובר ישירות אל הסוללה, הדק ה- Gate מחובר אל מוצא השמיט , השמיט בנוי כך שעבור תחום מתחים מוצא השמיט ישתנה בתחום ערכים ספציפי )פירוט בנספחים(. כאשר מתח הסוללה גדול מוצא השמיט הינו נמוך לכן יש הפרש פוטנציאלים בין הדק ה-Source להדק ה-Gate לכן הדק ה- Drane יקוצר עם הדק ה- Source ומתח הסוללה יעבור לשאר המעגל. וכאשר מתח הסוללה נמוך השמיט במוצאו יוציא גבוהה לכן בין הדק ה -Source להדק ה-Gate יש הפרש פוטנציאלים נמוך, לכן הדק ה-Drane ינותק מהדק ה -Source ולכן הסוללה לא תחובר לשאר המעגל כשהיא פרוקה. בנוסף למעגל המיתוג ישנו מחלק מתח שמחובר אל מתח הסוללה שנועד להקטין את מתח הסוללה כך שה 8266-ESP יוכל למדוד ערך זה. החוצץ נועד כדי שהתנגדויות של המערכות הבאות לא ישפיעו על מחלק המתח.

# פרק 4 תרשים זרימה

### 4.1 תרשים זרימה של התוכנית הראשית ביחידת ממשק המשתמש:

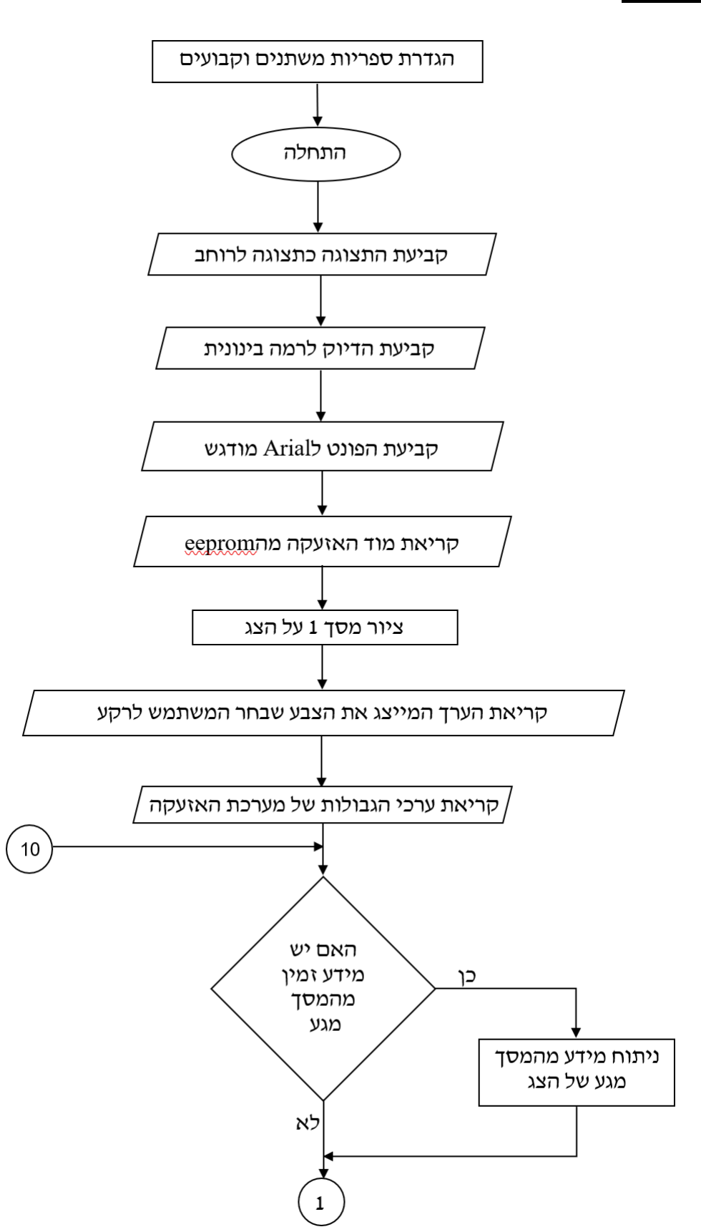
[picture p17: figure]

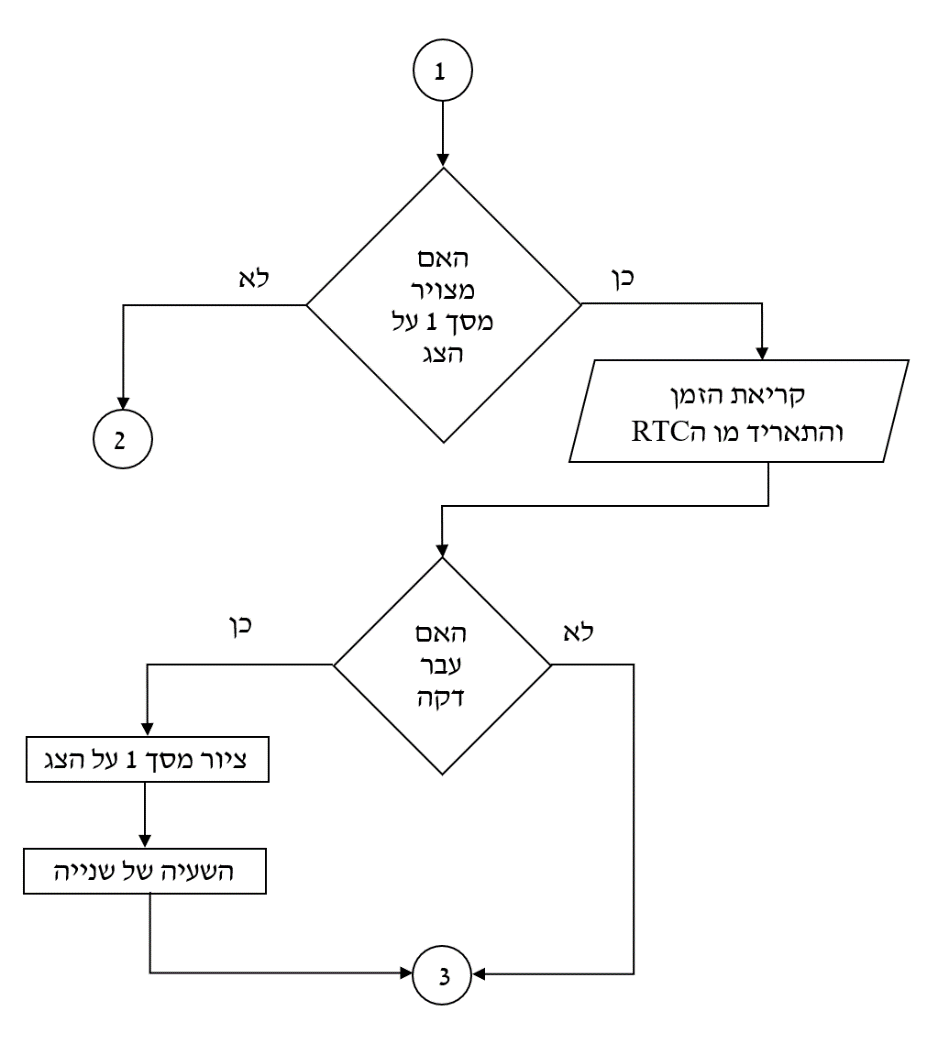
[picture p18: figure]

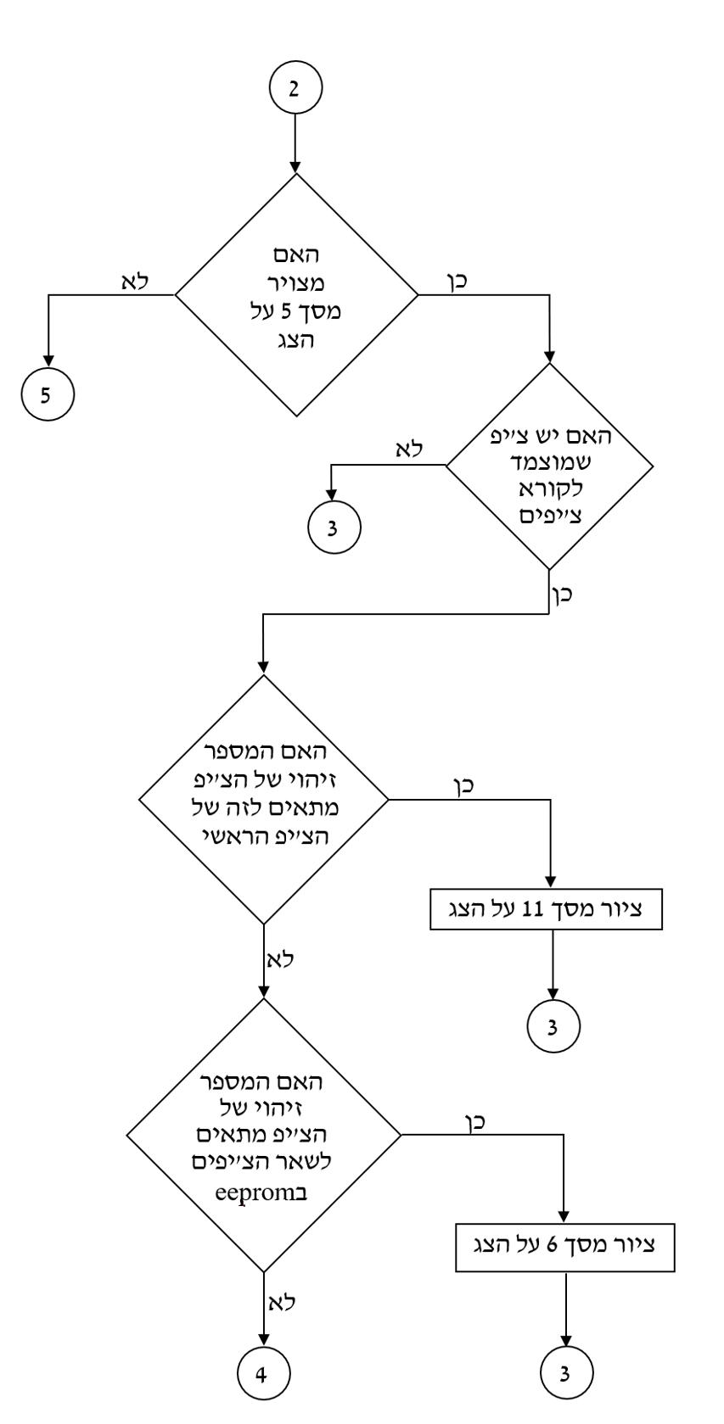
[picture p19: figure]

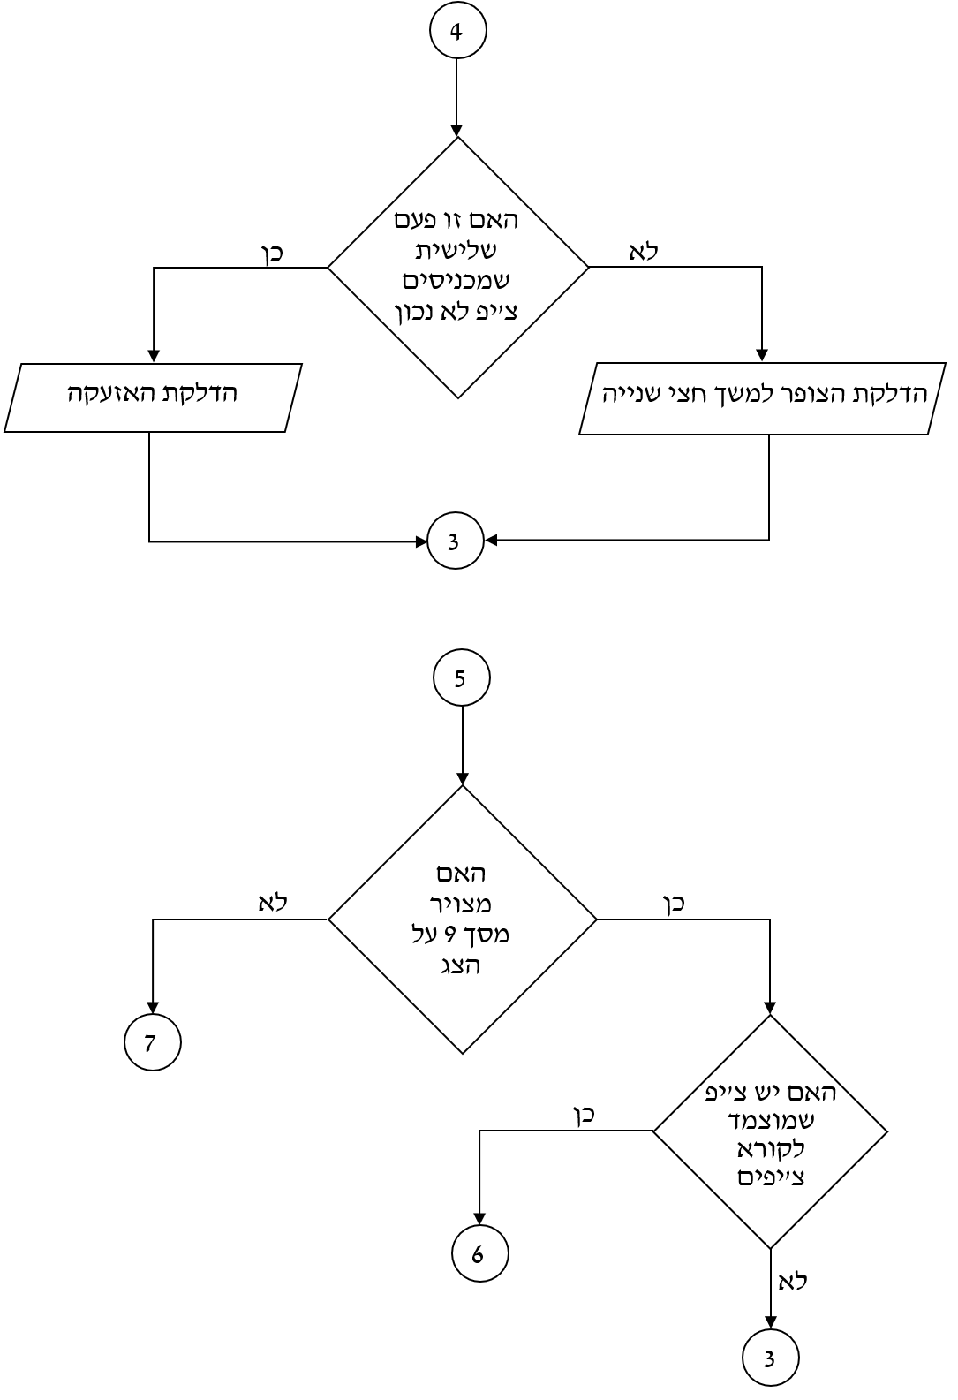
[picture p20: figure]

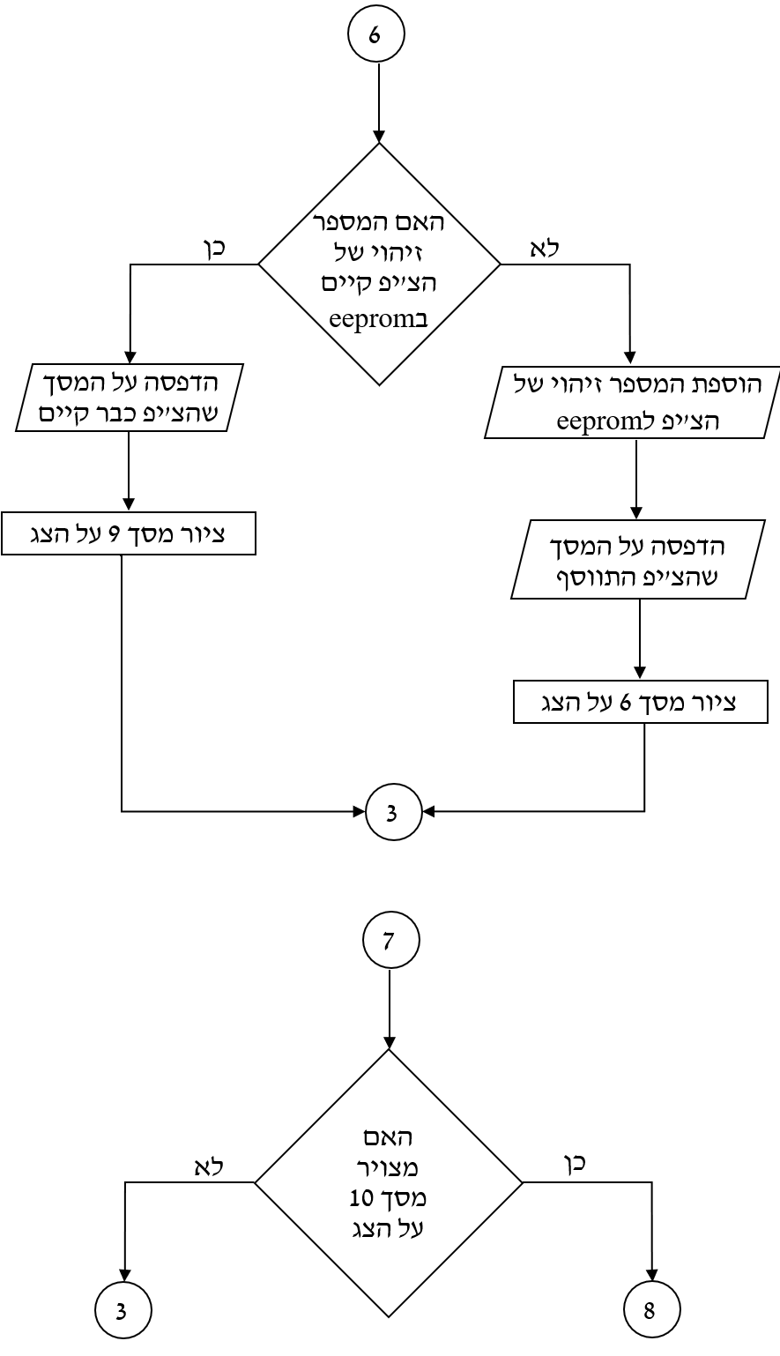
[picture p21: figure]
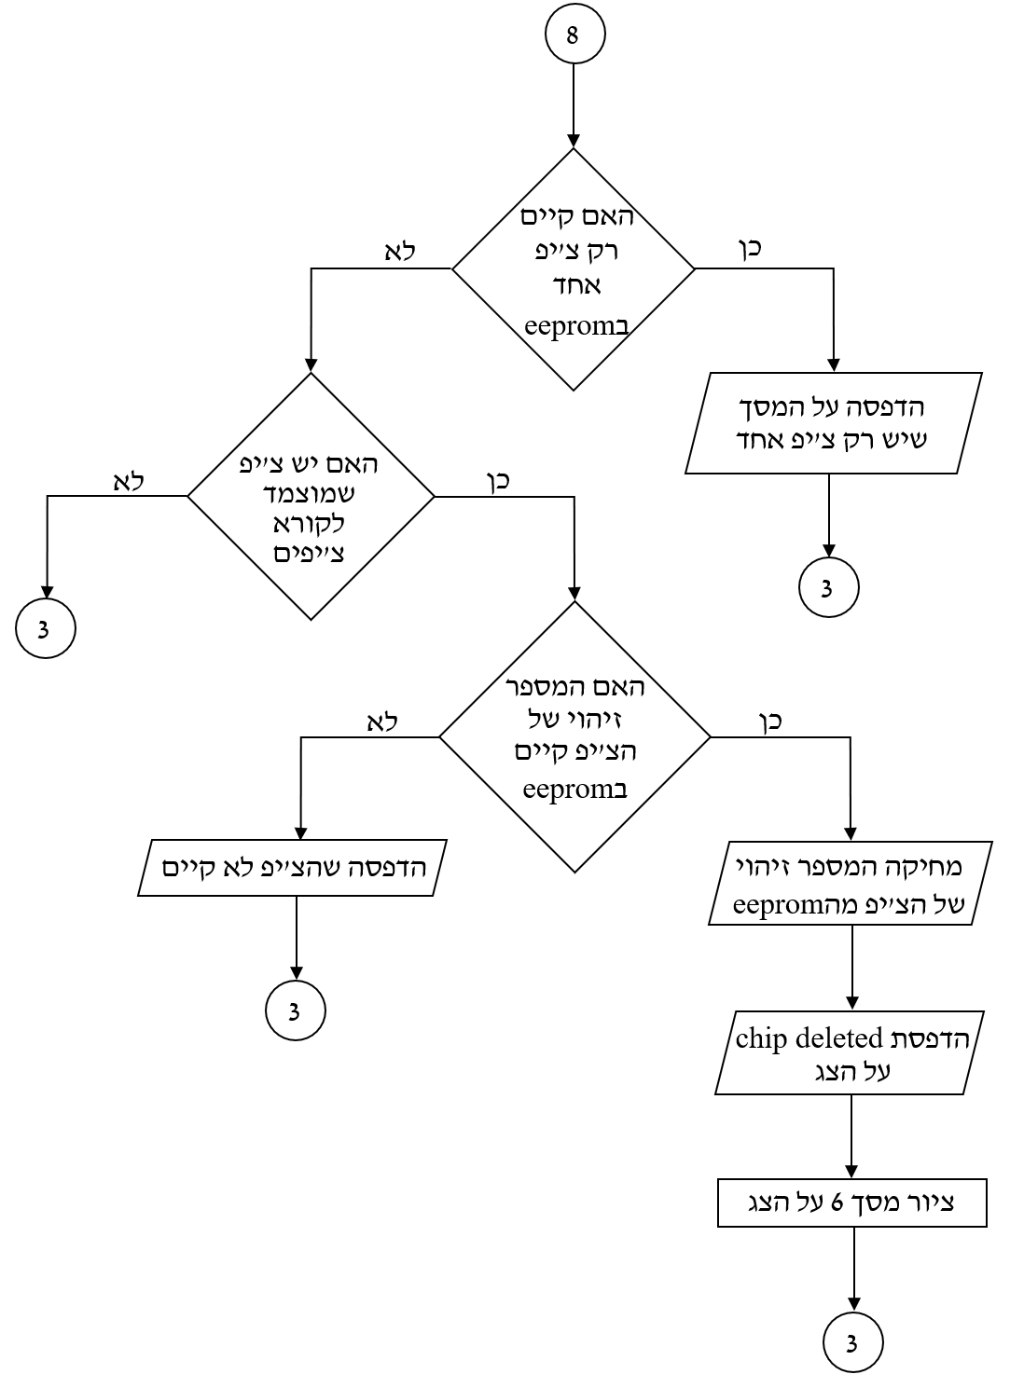
[picture p22: page 31]

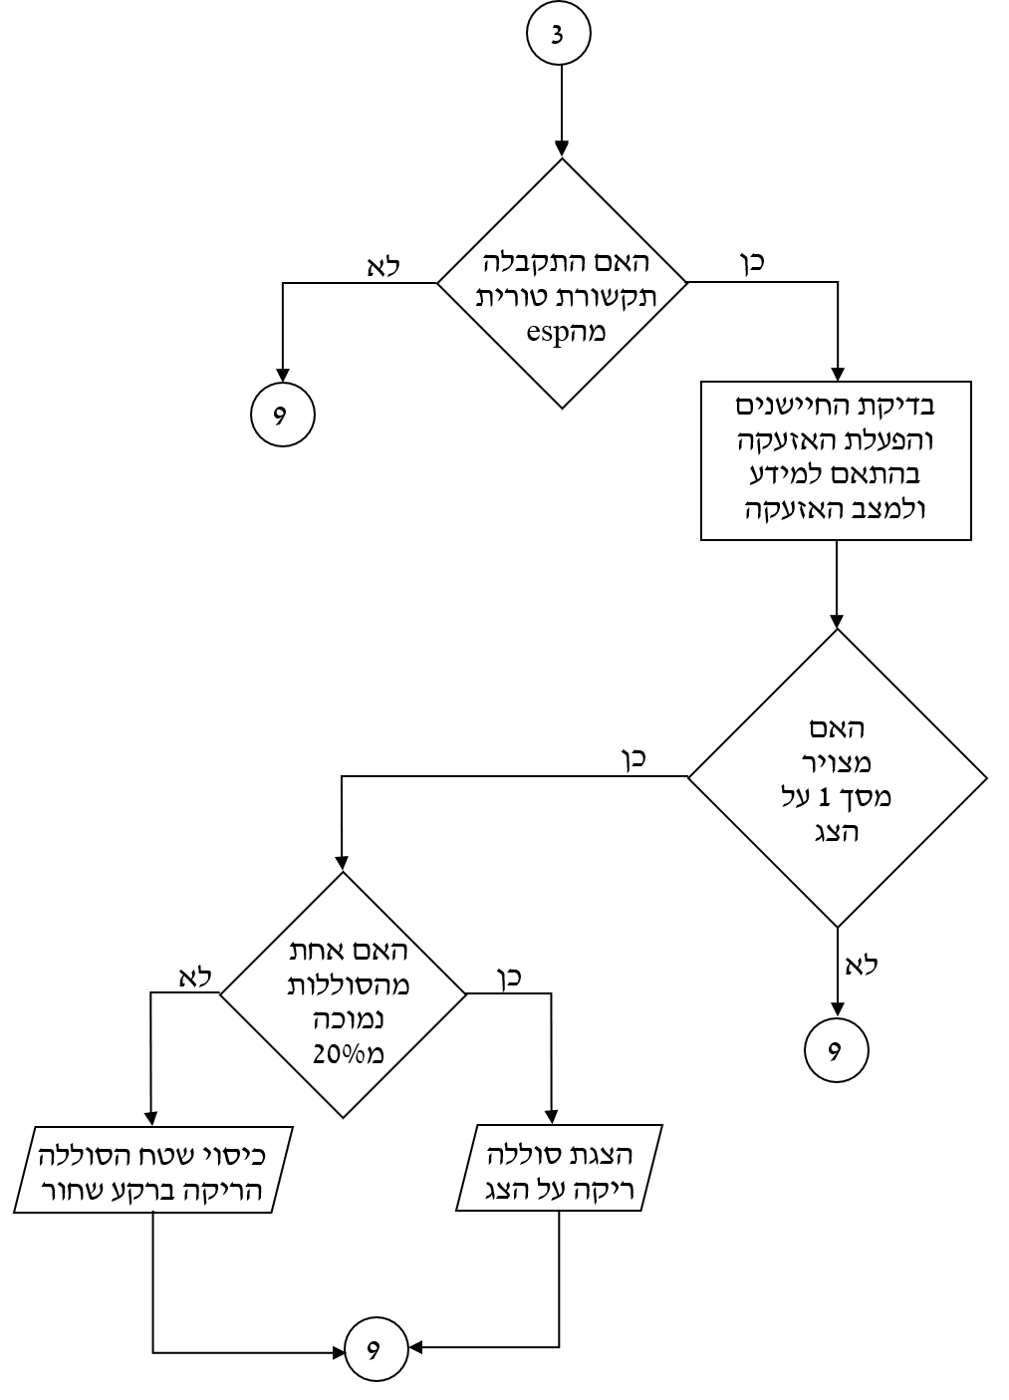
[picture p23: figure]

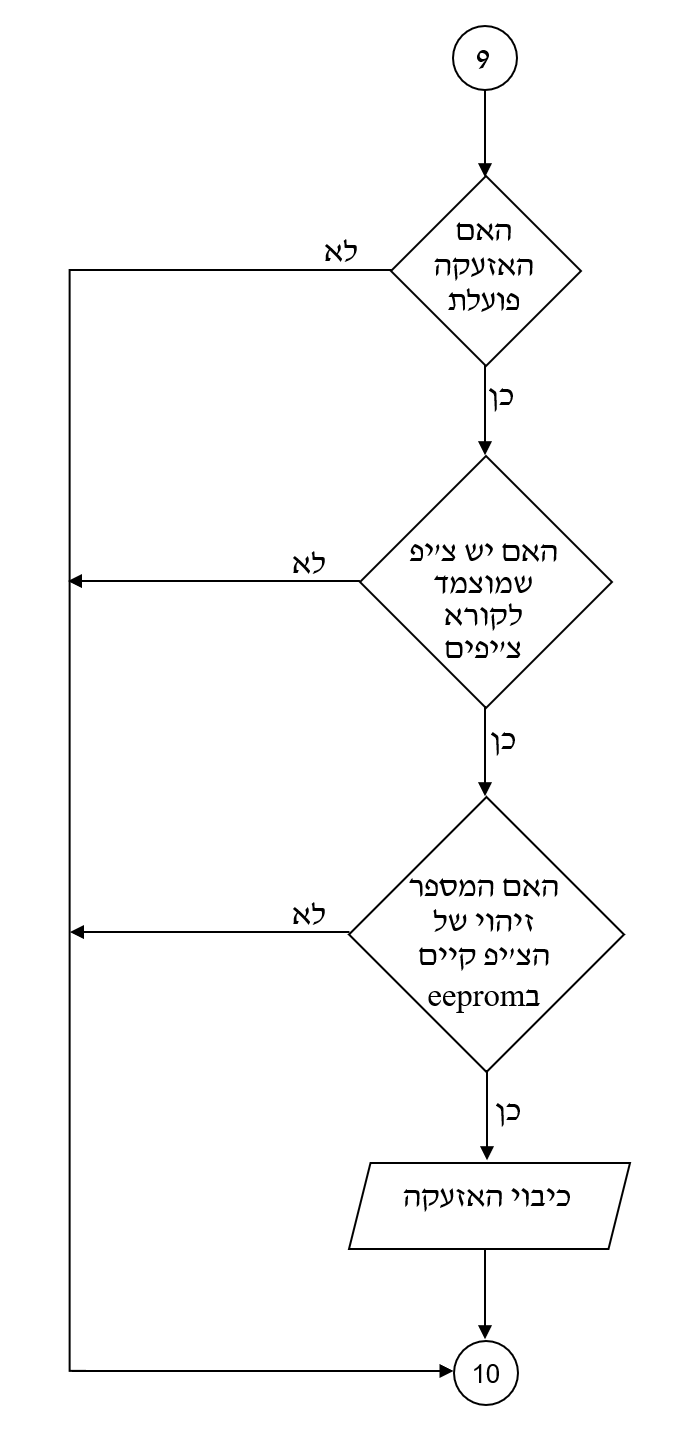
[picture p24: figure]

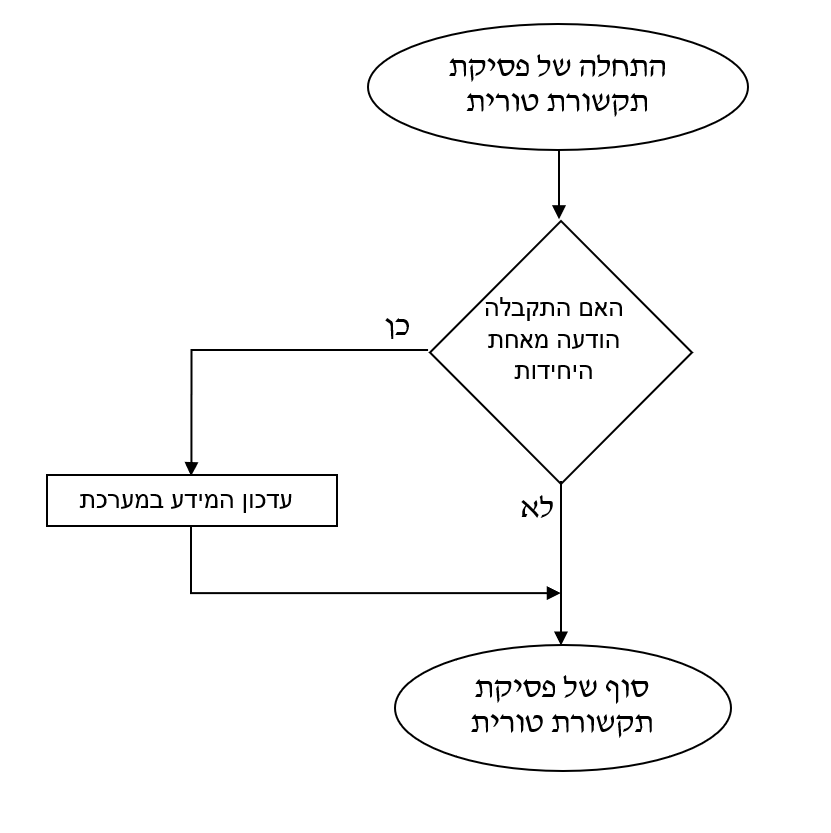
[picture p25: figure]

### 4.2 תרשים זרימה של התוכנית ב8266-ESP ביחידת ממשק המשתמש:

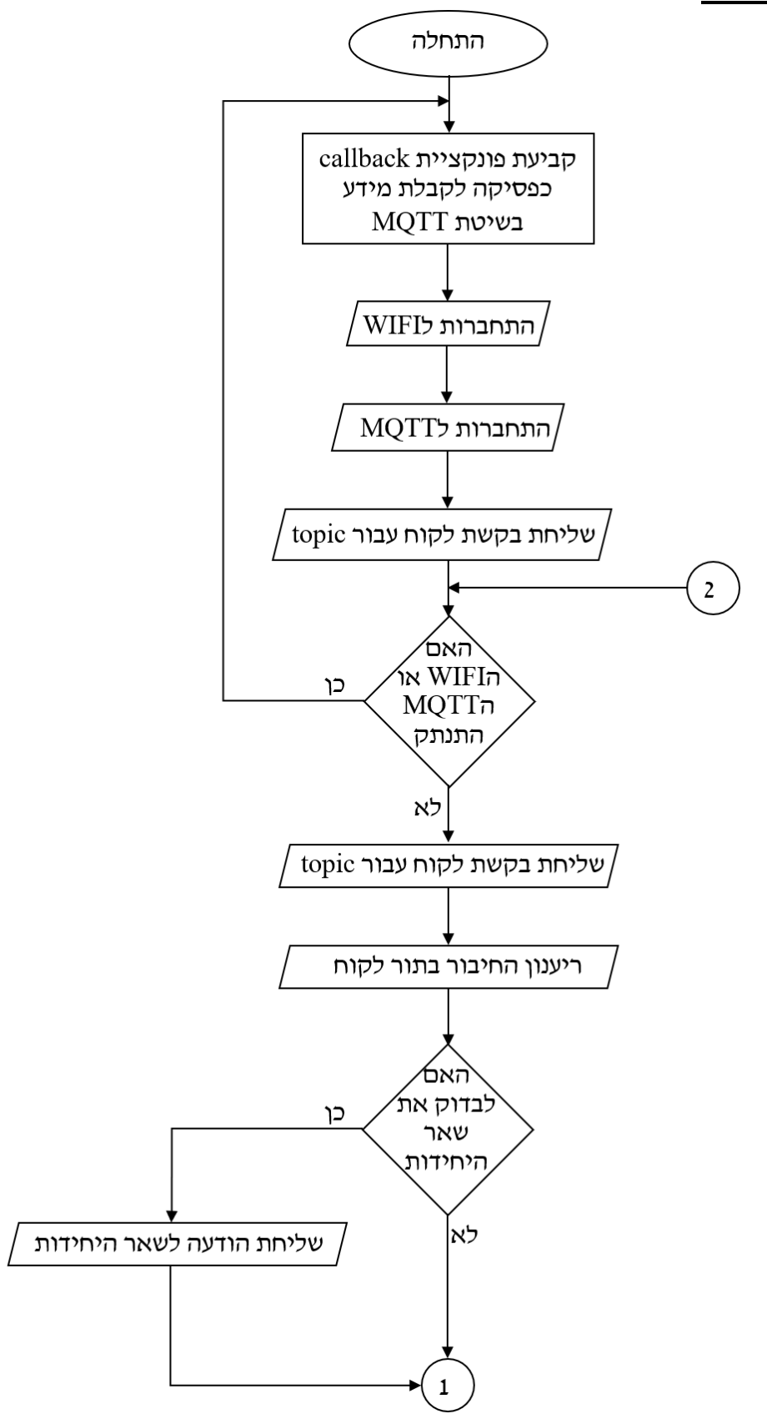
[picture p26: figure]

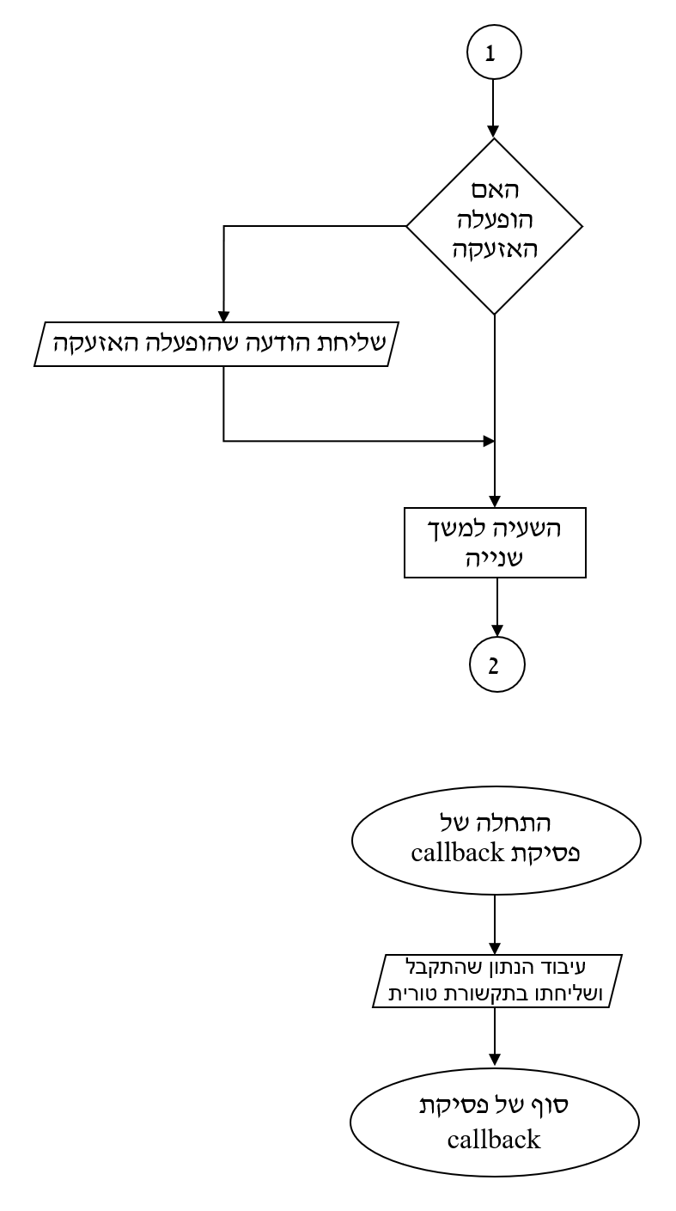
[picture p27: figure]

### 4.3 תרשים זרימה של התוכנית ב8266-ESP ביחידות החישה:

עקב מספר הרב של התוכניות ארשום תרשים אחד שיהיה עקרוני עבור כולם.

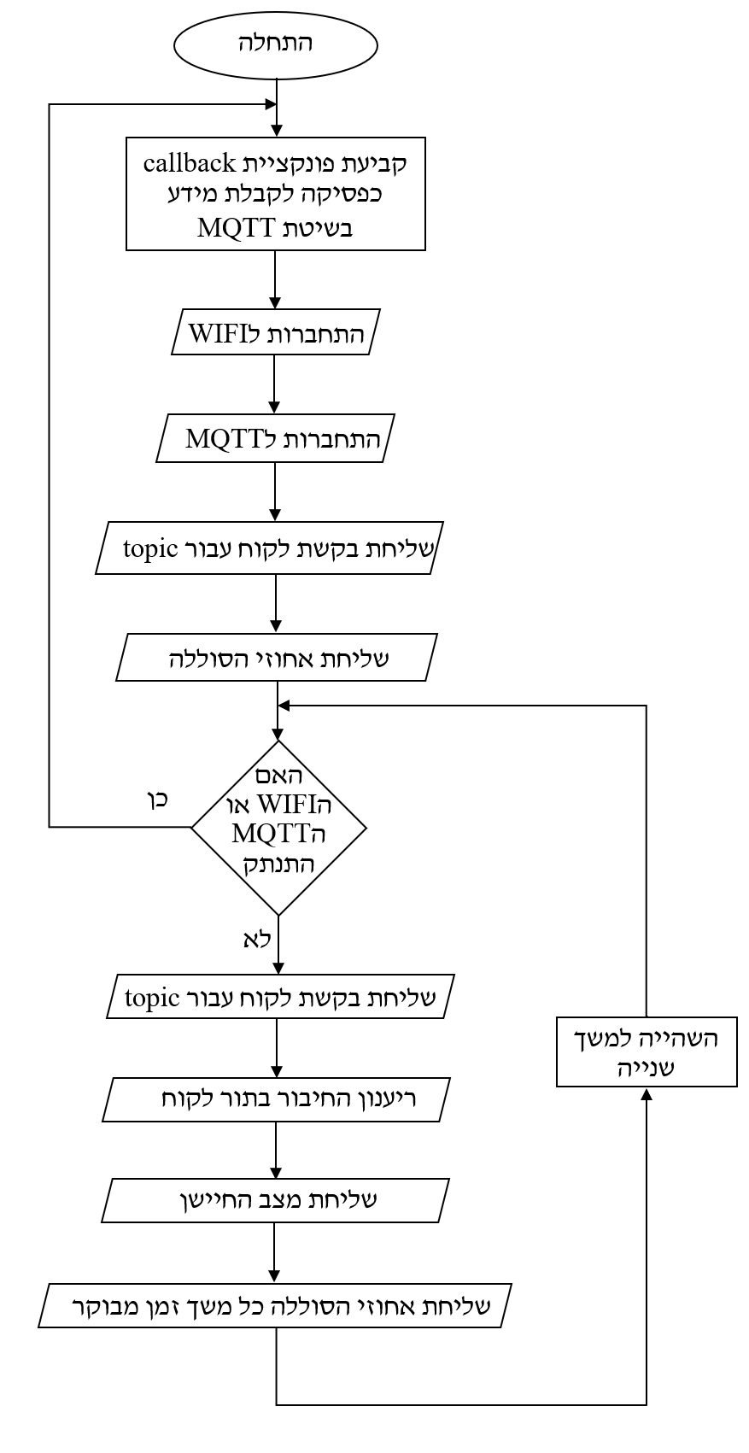
[picture p28: figure]

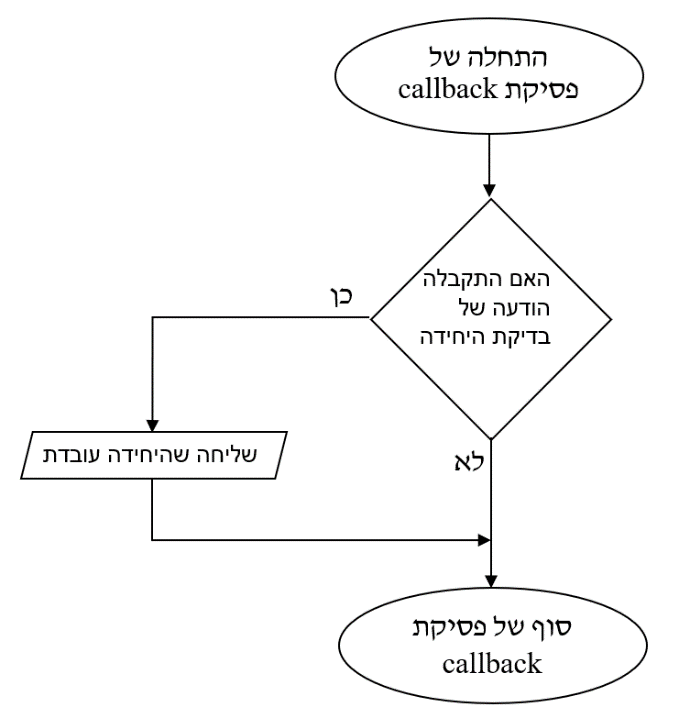
[picture p29: figure]

# פרק 5 תוכנה

### 5.1 התוכנה שצרובה ליחידת ממשק המשתמש:

לקטע הקוד המלא הנכם מוזמנים לצפות בדיסק שמצורף בסוף הספר.

הסבר התוכנה:
תחילה אנו מגדירים את ההגדרות הראשוניות של הרכיבים כגון: מספרי ההדקים, ספריות, הגדרת משתנים מחרוזות ומערכים גלובליים. לאחר מכן קובעים קצב עבודה והגדרת פינים בתור הדקי מוצא.

בתוכנה ישנם מספר מסכים שיודפסו הם ממוספרים מ1 עד 15 בתוכנית )לדוגמה 3drawLcd זה מסך 3(. בעזרת המסכים העבודה תהיה קלה למשתמש.

סדר המסכים:

מסך -1הצגת שעה, תאריך, יום, מוד אזעקה ואיור של סוללה ריקה במידה ואחת הסוללות ריקה.

מסך -2 האם להיכנס להגדרות המערכת או לראות את פרטי המערכת.

מסך -3 במסך זה מוצגים כל הפרטים העדכניים של החיישנים ואפשרות להיכנס ולראות את אחוזי הסוללות.

מסך -4 במסך זה מוצגים כל אחוזי הסוללות

מסך -5 במידה והמשתמש רצה להיכנס להגדרות הוא ייכנס למסך ז ה ופה יוצג לו להכניס תג זיהוי , בהתאם ל תג הוא יעבור למסך הבא.

מסך -6 במידה והוכנס צ'יפ רגיל נגיע למסך זה. במסך זה ישנם אפשריות לשנות צבע רקע, להוסיף עוד צ'יפ, למחוק צ'יפ או לשנות את מוד האזעקה.

מסך -7 במסך זה מוצגים למשתמש המודים של האזעקה לבחירה.

מסך -8 במסך זה מוצגים הצבעים שיוכל לבחור במידה וירצה לשנות את הצבע של הרקע.

מסך -9 מסך זה יודפס כאשר המשתמש ירצה להוסיף צ'יפ.

מסך -10 מסך זה יודפס כאשר המשתמש ירצה למחוק צ'יפ.

מסך -11 למסך זה נגיע רק אם נצמיד את הצ'יפ הראשי במסך 5 במסך זה נוכל לבחור אם לקבוע את גבולות מערכת האזעקה או לשנות שעה ותאריך או לבדוק את תקינות המערכת.

מסך -12במסך זה ניתן לבחור עבור איזה חיישן נשנה את גבולות האזעקה.

מסך -13 מסך שבו מוצגים מספרים להכנסת הערך שנרצה לשנות.

מסך -14 במסך זה נוכל לבחור אם לבדוק את הזמזם או את שאר היחידות.

מסך -15 במסך זה יודפס אם ישנם יחידות פועלות או שלא פועלות.

בחלקו העיקרי של התוכנית נבדוק אם יש לחיצה על המסך ובהתאם לכך אם לבצע פעולה כלשהיא, בנוסף אם מצויר מסך 1 אז נעדכן כל פעם את השעה והתאריך על המסך. את המידע של החיישנים משאר היחידות נקבל בתקשורת טורית, לכן בתוכנית הוגדרה פסיקה עבור קליטת הנתונים. לאחר כל קבלת נתון יתבצע בדיקה שלהם, אם הם תואמים לגבולות האזעקה של המצב פעולה הקיים, במידה ולא תופעל האזעקה. אין צורך לבדוק כל פעם את המידע כי רק עבור כל קליטת נתונים המידע משתנה, בין קליטה לקליטה הערכים נשארים קבועים. כאשר האזעקה מופעלת יש להצמיד צ'יפ )לא הראשי( כדי לכבות אותה. אם בתוכנית המשתמש נמצא במסך 9 או 10 ייבדק אם יש צ'יפ שמוצמד במידה וכן הוא יתווסף או יימחק )בהתאם למסך(.

הסבר ספריות:

h522.MFRC- ספרייה המכילה בתוכה פקודות לקריאת כל מידע שיש בצ'יפ בעזרת תקשורת SPI. אם יש צ'יפ זמין לקריאה או לא, פקודות לקריאת המספר זיהוי הצ'יפ או את כל המידע. בנוסף בספרייה זו כבר הוגדר אופן התקשורת בSPI המוד עבודה סדר שליחת המידע ומהירות העברת המידע.

h.URTouch- ספרייה המכילה בתוכה פקודות שקשורות למסך מגע של התצוגה גרפית, פקודות לזיהוי נגיעה על המסך מגע ולמיקום הלחיצה. בקבצים המצורפים ישנה תוכנית לביצוע כיול המסך מגע אל הצג.

h.SPI- ספרייה זו מאפשרת לתקשר עם התקנים דרך תקשורת SPI.

אל | הקשורות | פקודות | המכילות | ספריות | -ILI9341_due.h-ו ILI9341_due_config.h
התצוגה, הגדרת אופן התקשורת בSPI, הדפסת טקסט רקעים מסגרות ומיקומם על הצג. קביעת גודל הטקסט, מיקום הטקסט על הצג קביעת צבע הטקסט ועוד.

h.Wire- ספרייה המכילה בתוכה פקודות המאפשרות לתקשר עם התקנים דרך תקשורת .I2C

h1302.DS- ספרייה המכילה פקודות לקריאת השעה והתאריך מן הרכיב ועדכון השעה

והתאריך ברכיב הRTC.

טבלת פונקציות:

טבלה 3 - טבלת הפונקציות בתוכנית ביחידת ממשק המשתמש
מה הפונקציה מבצעת | מה הפונקציה מחזירה | מקבלת | שם הפונקציה מה הפונקציה
ממירה את הערך שמסמל את היום שמקבלים מן הRTC למחרוזת שניתן להדפיס על הצג. | את שם היום בשבוע בתור מחרוזת מסוג משתנה String | שמסמל את שם היום בשבוע | dayAsString הערך מ RTC
היום והתאריך. את מוד האזעקה והאם הסוללות ריקות | | | 1drawLcd כלום כלום מדפיסה על הצג את השעה,
.1מידע .2 הגדרת המערכת | | | 2drawLcd כלום כלום מדפיסה על הצג 2 מקשים
החיישנים ומקש של מצב הסוללות. | | | 3drawLcd כלום כלום מדפיסה על הצג את מצבי
הסוללות של המערכות | | | 4drawLcd כלום כלום מדפיסה על הצג את אחוזי
את התג זיהוי ואם הוא לא תקין | | | 5drawLcd כלום כלום מדפיסה שצריך להצמיד
אזעקה .2בחירת צבע .3הוספת תג זיהוי .4מחיקת תג זיהוי | | | 6drawLcd כלום כלום מדפיסה 4 מקשים .1מוד
האזעקה שניתן לבחור | | | 7drawLcd כלום כלום מדפיסה את כל מצבי

עם צבעים שונים לבחירת המשתמש לשינוי גוון הרקע | | | 8drawLcd כלום כלום מציגה על המסך 11 מקשים
| | | 9drawLcd כלום כלום מדפיס להצמיד צ'יפ חדש
שרוצים למחוק | | | 10drawLcd כלום כלום מדפיס להצמיד את הצ'יפ
חיישנים .2בדיקת המערכת | | | 11drawLcd כלום כלום מדפיס 2 מקשים .1הגדרת
היחידות שעבורן נרצה לשנות את הערך. | | | 12drawLcd כלום כלום מדפיסה את שמות
מספרים מ0 עד 9 וגם מקש Enter וClear בשביל שנוכל להכניס ערך לשינוי | | | 13drawLcd כלום כלום מדפיסה לוח מקשי
הזמזם .2בדיקת יחידות החיישנים | | | 14drawLcd כלום כלום מדפיסה 2 מקשים .1בדיקת
פועלות או שלא | | | 15drawLcd כלום כלום מדפיסה אם שאר המערכות
הפונקציות של drawLcd | | | drawReturn כלום כלום מדפיסה מקש חזור בכל
בזיכרון ואת הגוון שבחר המשתמש בצג לצבע. | | כלום כלום ממירה את המספר השמור | colors
קוראת את המספר זיהוי של הצ'יפ | ונקרא צ'יפ או 0 במידה ולא | | readUIDchip כלום 1 במידה
במידה ומצמידים אותו | | | chip_add כלום כלום מוסיפה לזיכרון צ'יפ

והוא עם מספר זיהוי חדש, במידה ומספר הזיהוי קיים תודפס הודעה בהתאם.

במידה ומצמידים אותו והוא עם מספר שקיים בזיכרון, במידה ואינו קיים תופיע הודעה בהתאם. | | | chip_del כלום כלום מוחקת מהזיכרון צ'יפ
בודקת אם מספר הזיהוי של הצ'יפ קיים בזיכרון או שלא | התחלתית של מספר זיהוי הצ'יפ או 0 | | chip_cheak כלום כתובת
שהתקבל לפונקציה בכתובת שהתקבלה בזיכרון | כלום שומרת את המידע | ההתקן .2הכתובת שאליה רוצים לשמור את המידע .3 מידע בגודל בית אחד | writeEEPROM .1כתובת
קוראת את המידע מהזיכרון מהכתובת שהתקבלה ומחזירה את המידע | מידע בגודל בית אחד | ההתקן .2כתובת שבה רוצים לקרוא את המידע | readEEPROM .1כתובת
המסגרת תהיה בצבע אדום ועוצרת את התוכנית עד לעזיבת המקש | כלום כל עוד המקש לחוץ | הערכים של המקש שנלחץ | waitForIt
בתור זמן כדי לצאת מהבית | | | runTime כלום כלום הדפסת 30 שניות למשתמש

אם הגדיר במערת מצב שהוא מחוץ לבית

משאר היחידות במידה ויש סוללה שקטנה מ20% היא תצייר סוללה ריקה | כלום כלום בודקת את אחוזי הסוללה | checkBatt
לא מחוץ לגבולות שהוגדו בהתאם למוד האזעקה במידה וכן תופעל האזעקה | כלום כלום בודקת אם ערכי החיישנים | checkSensor
כגבולות עבור מערכת האזעקה | | almLim כלום כלום קריאת הערכים שהוגדרו
שהוגדרה כדי לקבל את המידע משאר היחידות. | | 1serialEvent כלום כלום פסיקה לתקשורת טורית

### 5.2 התוכנית שצרובה ל8266-ESP ביחידת ממשק המשתמש:

לקטע הקוד המלא הנכם מוזמנים לצפות בדיסק שמצורף בסוף הספר.

הסבר התוכנה:

תחילה נתחבר אל הנקודת גישה שהוגדרה, ולאחר מכן לMQTT. לאחר ההתחברות

נשלח בקשה בשביל להיות מנויים עבור מספר נושאים )topics )ונגדיר את פונקציית

callback כפסיקה לקבלת מידע בשיטת תקשורת MQTT. במידה וההתחברות הצליחה נמשיך לתוכנית במידה ולא יתבצע איפוס והתוכנית תתחיל מחדש. בתוכנית הראשית ייבדק מצב האזעקה ושליחת הודעה בהתאם לכך, בנוסף ייבדק אם יש דרישה לבדוק את שאר היחידות אזעקה במידה וכן יישלחו אליהם הודעת בדיקה, במידה ולא הוחזר תשובה במשך 20 שניות תישלח הודעה שלילית בתקשורת טורית אל ה ARDUINO DUE במידה והוחזרה תשובה שההתקן פעיל תישלח הודעה חיובית. בכל קבלה של הודעה בתקשורת MQTT תתחיל פונקציית callback לעבוד. בפונקציה זו ננתח את המידע שהתקבל נקצר אותו ונשלח אותו מקוצר בתקשורת טורית. בתוכנית יתבצע כל פעם ריענון בשביל להישאר לקוח עבור הנושאים שנרצה לקבל עבורם מידע.

הסבר ספריות:

h.PubSubClient- בספרייה זו קיימים הפקודות לתקשור הרכיב עם הברוקר דרך

תקשורת MQTT, הפקודות לשליחת מידע, שליחת בקשת לקוח, קבלת מידע עבור נושאים שרצינו לקבל מידע עליהם.

h.WiFi8266ESP- בספרייה זו קיימים הפקודות כדי להתחבר לנקודת גישה של Fi-Wi שפרטיו הוגדרו בתוכנית. בנוסף פקודות על בדיקת מצבו של החיבור, אם החיבור עדיין קיים או שהתנתק.

טבלת פונקציות:

טבלה 4 - טבלת פונקציות של ה 8266-ESP ביחידת ממשק המשתמש
מה הפונקציה מבצעת | מה הפונקציה מחזירה | מקבלת | שם הפונקציה מה הפונקציה
שהתקבל ושליחת מידע מקוצר דרך תקשורת טורית ל ARDUINO DUE | כלום ניתוח המידע | .1הנושא ) topic ) שממנו התקבל המידע .2כתובת התחלתית שבה נשמר המידע .3אורך המידע | Callback 3 ערכים:
הFi-Wi ואל הMQTT | | | reconnect כלום כלום התחברות אל

### 5.3 התוכנה שצרובה ל8266-esp שמחובר לחיישן גז:

לקטע הקוד המלא הנכם מוזמנים לצפות בדיסק שמצורף בסוף הספר.

הסבר התוכנה:

תחילה נתחבר אל הנקודת גישה שהוגדרה, ולאחר מכן לMQTT. לאחר ההתחברות

נשלח בקשה בשביל להיות מנויים עבור מספר נושאים )topics )ונגדיר את פונקציית

callback כפסיקה לקבלת מידע בשיטת תקשורת MQTT. במידה וההתחברות הצליחה נמשיך לתוכנית במידה ולא יתבצע איפוס והתוכנית תתחיל מחדש. בתוכנית הראשית נבדוק את מצב החיישן ונשלח את המידע בנושא )topic )משלו ובנוסף נבדק כל זמן מסוים אחוזי הסוללה במידה והם מעל 20% אז הבדיקה תהיה כל רבע שעה אחרת כל 5 דקות. במידה והתקבלה הודעה שהיחידה עובדת תישלח תגובה בהתאם. בתוכנית יתבצע כל פעם ריענון ב שביל להישאר לקוח עבור הנושאים שנרצה לקבל עבורם מידע.

הסבר ספריות:

h.PubSubClient- בספרייה זו קיימים הפקודות לתקשור הרכיב עם הברוקר דרך

תקשורת MQTT, הפקודות לשליחת מידע, שליחת בקשת לקוח, קבלת מידע עבור נושאים שרצינו לקבל מידע עליהם.

h.WiFi8266ESP- בספרייה זו קיימים הפקודות כדי להתחבר לנקודת גישה של Fi-Wi שפרטיו הוגדרו בתוכנית. בנוסף פקודות על בדיקת מצבו של החיבור, אם החיבור עדיין קיים או שהתנתק.

טבלת פונקציות:

טבלה 5 - טבלת פונקציות של אחת מיחידות החישה
מה הפונקציה מבצעת | מה הפונקציה מחזירה | מקבלת | שם הפונקציה מה הפונקציה
התקבלה הודעת בדיקת תקינות היחידה ותגובה בהתאם | כלום בדיקה אם | .1הנושא ) topic ) שממנו התקבל המידע .2כתובת התחלתית שבה נשמר המידע .3אורך המידע | Callback 3 ערכים:
הFi-Wi ואל הMQTT | | | reconnect כלום כלום התחברות אל
הסוללה ושליחת ההודעה בנושא בMQTT | | | battPerPub כלום כלום בדיקה של אחוזי
ושליחת המידע בנושא בMQTT | | | senPerPub כלום כלום בדיקת החיישן
המספרי לתווים אסקיים | כלום ממיר את הערך | או של החיישן | senPerPub ערך של הסוללה

# פרק 6 זיווד

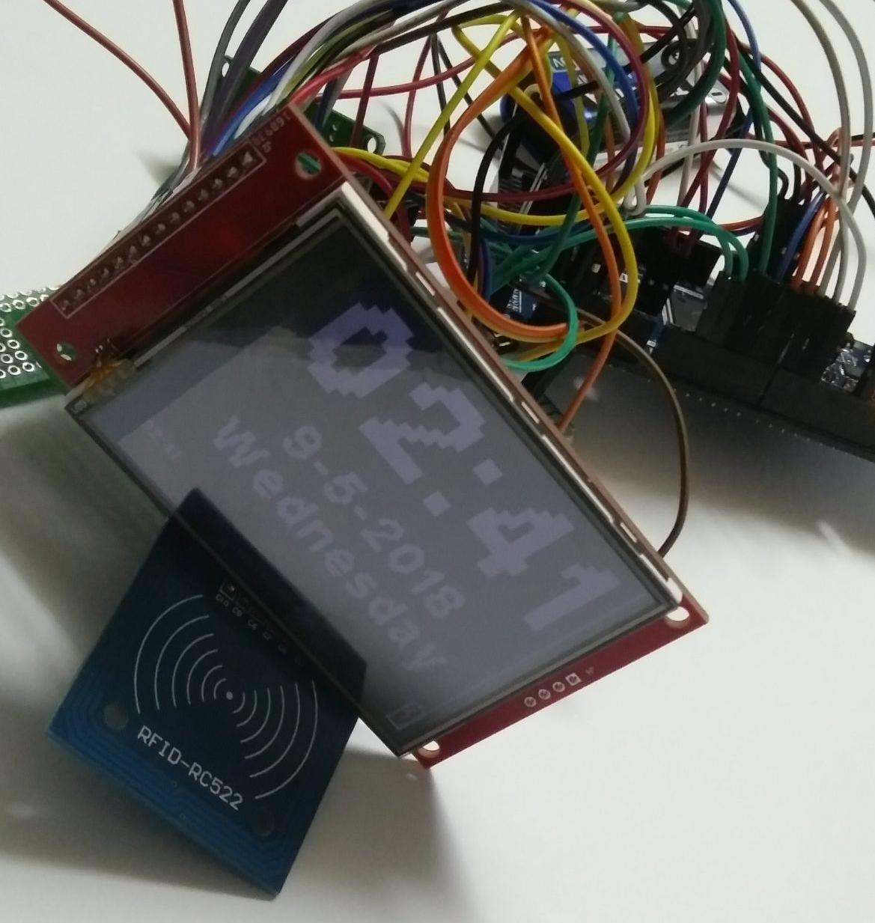
[picture p30: figure]

איור 8 - ממשק למשתמש

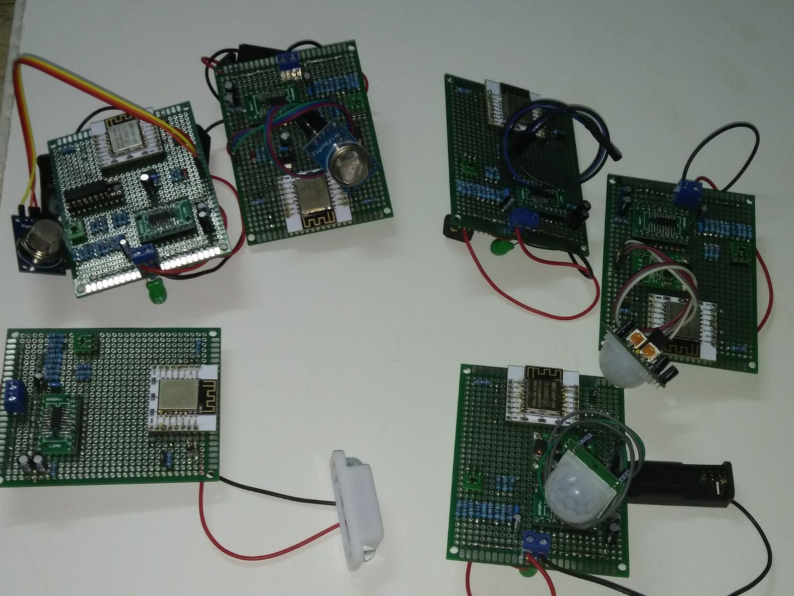
[picture p31: figure]

איור 9 - חיישני החישה

# פרק 7 סיכום

### 7.1 פרק תקלות במהלך העבודה:

במהלך העבודה נתקלנו בבעיה עם החיישני גז בישול וחיישן העשן שלא פעלו, ברגע חיבורם למעגל חלק מן הרכיבים כבו ולא עבדו לאחר בדיקה מעמיקה גילינו כי עבור מתח סוללה של 4LiFePO לא מספק לרכיב up step מספיק מתח בשביל שיספק זרם לחיישן הגז בישול או העשן. פתרתי את הבעיה באמצעות חיבור שני סוללות ועם דיודת זנר למבוא המעגל.

בנוסף כאשר חיברתי את אחד ממעגלי יחידות החישה לספק, המתח שנמדד הינו היה נמוך ממה שנקבע בספק, חיבור של קבלי טנטלום במבוא יחידת החישה פתר את הבעיה.

## 7.2 פרק סיכום והסקת מסקנות:

העבודה עם הפרויקט הייתה מאוד מהנה, למדנו על רכיבים חדשים הכרנו איך לעבוד איתם ואת אופן פעולתם. לבצע תקשורת בין רכיבי 8266ESP דרך ה -Fi-Wi ולתקשר איתם דרך אפליקציה של MQTT.

החלק שאהבתי זה לתקשר עם 8266ESP עם אפליקציה )עבור אנדרואיד( ולשלוט על לד המחובר לאחד מהדקי ה- 8266ESP

הצעות לפיתוח עתידי:
הוספה של מצלמת אבטחה שתצלם בזמן אמת את הבית ואנשי הבית יוכלו לצפות בה בכל זמן שירצו.

שימוש במעגלים מודפסים ורכיבים קטנים כדי שהמעגל יהיה קטן, כדי שיחידות החישה לא יבלטו ברחבי הבית.

# פרק 8 ביבליוגרפיה

http://www.cobox-ebikes.com/296/basic-understanding-of-lipo-li-ion-and-lifepo4.html (http://www.cobox-ebikes.com/296/basic-understanding-of-lipo-li-ion-and-lifepo4.html)

https://www.hivemq.com/blog/mqtt-essentials/page/2/

https://www.mysensors.org/build/gas

https://www.arduino.cc/reference/en/

https://io.adafruit.com/dashboards

http://jansson.us/resistors.html

https://www.random-science-tools.com/electronics/inverting-schmitt-trigger-calculator.htm (https://www.random-science-tools.com/electronics/inverting-schmitt-trigger-calculator.htm)

# פרק 9 נספחים

:Arduino Due 9.1

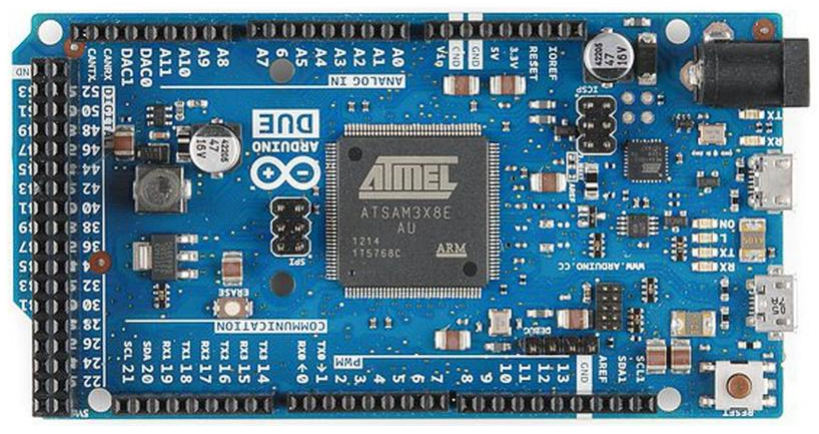
[picture p32: figure]

Arduino Due -10 איור

ערכת הפיתוח DUE ARDUINO הוא המוח המפעיל את רכיבי המערכת ביחידת

התצוגה גרפית. בכרטיס זה נמצא המיקרו בקר E8X3SAM91AT המתבסס על

מעבד CPU 3M-CORTEX. הבקר כולל: 54 חיבורים דיגיטליים המשמשים כקלט פלט, 12 הדקים אנלוגיים המשמשים כהדקי מבוא, 4 ערוצים של תקשורת UART, שעון של MHZ ,84 זיכרון FLASH בגודל של KB,512 כפתור RESET וכפתור למחיקה. בשונה משאר ערכות הפיתוח ערכה זו מתבססת על מתח של v.3.3 המתח הפעלה של ה-DUE ARDUINO הוא v.7-12

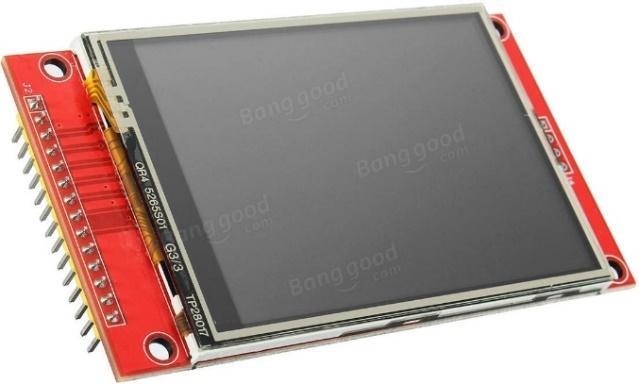
[picture p33: figure]

איור 11 - תצוגה גרפית

### 9.2 תצוגה גרפית עם מסך מגע:

המסך הינו תצוגה גרפית עם מסך מגע בעל רזולוציה של 240x320 בעל 262 אלף צבעים. התצוגה גרפית היא תצוגת גביש נוזלי )LCD). ההתקשרות עם המסך היא באמצעות

תקשורת SPI. לתצוגה גרפית הדרייבר הוא 9341ili ולמסך מגע הדרייבר הוא

2046xpt, שני הדרייברים עובדים במתחי הפעלה של v.3.3 למסך יש זיכרון גרפי של 172,800 בתים כדי לאחסן את תמונת הצג. המסך מגע הינו מסך התנגדותי הכולל מספר שכבות, והחשובות שבהן הן שתי שכבות דקות, שקופות, עמידות לחשמל, המופרדות על ידי שטח דק. שכבות אלה פנים אל פנים עם מרווח דק ביניהם, לכל שכבה יש מוליכים בצדדים כאשר המוליכים בין שני השכבות מאונכות זו לזו ובכך שלוחצים על המסך משטחים אלה מוליכים ובכך ניתן לדעת את מיקום הלחיצה. היתרון של מסך התנגדותי היא שעבור כל לחיצה עם לחץ מסוים. סוג זה של מסך הינו מסוג wire.4

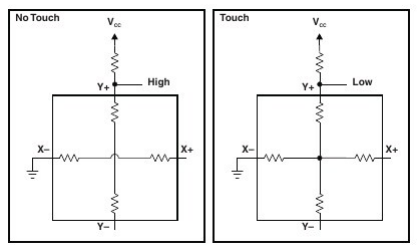
[picture p34: figure]

איור 12 - תיאור של מסך התנגדותי

### 9.3 צופר BUZZER:

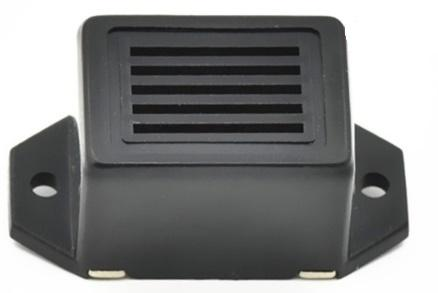
[picture p35: figure]

איור 13 - יחידת הצופר

BUZZER הוא צופר בעל התנגדות של Kohm,1 ה-BUZZER יכול לקבל תחום מתחים של V,3-12 ולהפיק עוצמת רעש של עד dB.85 אנו בפרויקט מחברים את הדק המינוס לאדמה ואת הדק הפלוס להדק דיגיטלי של 11 המפיק V3.3 כאשר האזעקה צריכה לפעול. תדר התהודה של הצופר הוא 400 פלוס מינוס ,100 ומשקלו כ-g.85 הרכיב עובד בטמפרטורה של כ 25-70- מעלות וניתן לאחסן אותו בטמפרטורה של -30 עד 80 מעלות.

### 9.4 שעון זמן אמת 1302DS RTC:

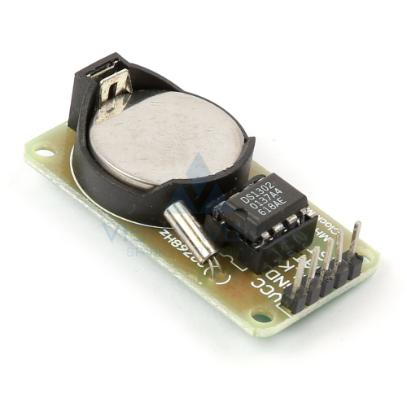
[picture p36: figure]

RTC DS1302 - 14 איור

1302DS, הוא שעון זמן אמת הסופר: שניות, דקות, שעות, תאריך, חודש, יום בשבוע ושנה. השעון כולל סוללת גיבוי הפועלת גם כאשר אינה מחוברת לספק חיצוני המשמשת לרכיב להמשיך בפעולתו התקינה ולהגנת הזיכרון הנדיף RAM בעל 31 בתים. מתח הפעולה של הרכיב הוא בין v2 עד v5.5 , תחום המתחים הזה מגדיל את חיי הפעולה סוללות הגיבוי )המתח המגיע מה -DUE ARDUINO שלנו בפרויקט מעניק לשעון מתח של V5). הזרם במתח של V2 הוא mA300 זרם זה הוא זרם נמוך מאוד מה שמאפשר חיי סוללה ארוכים עקב צריכת זרם נמוכה. השעון עובד בתחום טמפרטורה של -40 עד 85 מעלות. פעולת התקשורת של השעון עם ה- ARDUINO

DUE מתרחשת בעזרת תקשורת טורית סינכרונית הממומשת בעזרת שלושה חיבורים:

CE- אפשור הרכיב, הדק זה פעיל בגבוה כאשר אנו רוצים לקרוא או לכתוב לשעון.

CLK- שעון סריאלי, תפקיד השעון הוא לתזמן את העברת המידע ולאפשר פעולה

סינכרונית בין השעון ל- DUE ARDUINO או להפך.

DATA- הדק זה נועד לשם העברת המידע בין השעון ל- DUE ARDUINO ולהפך. המידע יכול להיות מעובר מהשעון בתור בית אחד, או בצרור של נתונים שמגיע עד ל 31-בית.

### 9.5 חיישן זיהוי צ'יפים RFID:

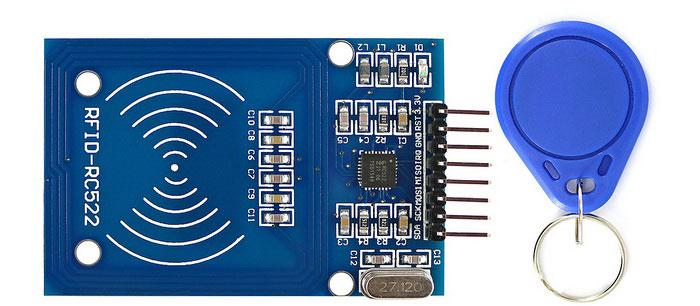
[picture p37: figure]

איור 15 - קורא צ'יפים וצ'יפ

RFID הינם ראשי תיבות של Identification Frequency Radio, בעברית זיהוי באמצעות תדרי רדיו, המאפשרת איתור פריטים וזיהוי חפצים בצורה אלחוטית, ללא צורך בשדה ראייה או במגע ישיר מול החפץ אותו רוצים לזהות. טכנולוגית ה-RFID הינה טכנולוגיה ותיקה שגרסאות שלה התפתחו עוד בשנות ה,20- והטכנולוגיה בצורתה הנוכחית התפתחה כבר בסוף שנות ה .60- אך טכנולוגיית ה-RFID החלה לצבור תאוצה וקהל לקוחות רחב רק בשנים האחרונות. זאת מכיוון

שבעבר, טכנולוגיית ה- RFID הייתה מאוד יקרה, טווחי הקריאה היו מצומצמים ועלות התגים הייתה מאוד גבוה.
כיום, עם התפתחויות הטכנולוגיות האחרונות ומזעור השבבים, עלות התגים ירדה משמעותית, מרחקי הקריאה השתפרו וגדלו, והטכנולוגיה מסוגלת ליותר יישומים מעשיים כמו: אחסנה, ניהול מלאי, לוגיסטיקה, מחסנים ממוחשבים, רפואה ועוד. טכנולוגיית ה -RFID משתמשת בשדה אלקטרומגנטי הנוצר ע''י קורא קרבה ) RFID

reader )להעברת אנרגיה לתגי הקרבה )tags RFID )בטווחים קצרים. בעזרת האנרגיה שנוצרה ע''י השדה, תגי הקרבה מסוגלים ללא צורך במקור מתח חיצוני ומשדרים לקורא קרבה את תוכן הזיכרון הצרוב בתוכם.

### סוגי תגי RFID:

ישנם שלושה סוגים של תגיות RFID: .1 תג פאסיבי - תג ללא מקור מתח משל עצמו )סוללה(. זהו התג שאנו משתמשים בפרויקט.
.2 תג אקטיבי - תג בעל מקור מתח משל עצמו )סוללה(, בעל טווח גדול יותר וזיכרון גדול יותר מתג פאסיבי. .3 תג פאסיבי למחצה – דומה לתג פאסיבי אך יש בו סוללה קטנה יותר מהאקטיבי שמאפשרת לו להיות טעון תמידית.

### תדרים בשימוש טכנולוגיית ה-RFID:

ישנם ארבעה אורכי גל מרכזיים הנמצאים בשימוש RFID: .1 תגי אורך גל נמוך - KHz125 או KHz.134.2

.2 תגי אורך גל גבוה - MHz13.56( אורך הגל שלנו(

.3 תגי אורך גל אולטרה גבוה )UHF )- MHz868 או MHz.959

.4 תגי גלי מיקרו - MHz2450 ואפילו יותר

### אופן פעולת ה-RFID פרוייקט שלנו:

אנו משתמשים ב-RFID בפרויקט שלנו לשם זיהוי כניסת המשתמש לבית, או האם מדובר בכניסת הטכנאי למערכת. דרך האנטנה משודרת אנרגיה תדרי רדיו, התגית מקבלת אנרגיה זו ומחזירה ל- RFID דרך האנטנה בתדרי רדיו את הקוד הצרוב על

התגית, ה- RFID מעביר את הנתונים אל ה- DUE ARDUINO בתקשורת SPI, ולאחר

מכן ה -DUE ARDUINO מעביר בתקשורת SPI אל הצג האם הצ'יפ מתאים או לא, ובכך המשתמש יודע האם ניתנת לו הרשאה לבית.

:ESP8266-12S | בקר | 9.6

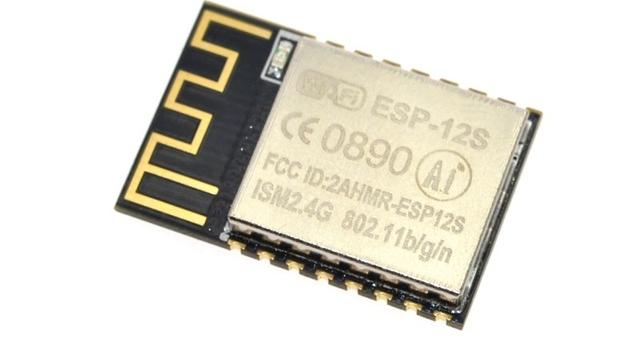
[picture p38: figure]

איור 16 - 8266ESP

בקר S8266-12ESP, הוא רכיב בר תכנות באמצעות סביבת העבודה ARDUINO

הניתן להתחברות לרשתות WIFI בעזרת סטנדרט אלחוטי של n/g/b .802.11 בקר זה

בעל 32 סיביות הכולל IP/TCP, מהירות שעון של MHz80 ו- MHz,160 מופעל

במתחים של v3.3 עד v,3.7 וניתן לתפעול בטמפרטורה של -40 עד 85 מעלות צלזיוס. באמצעות רכיב זה אנו יכולים לתקשר עם כל המערכות בפרויקט כאשר לכל מערכת קיים בקר S8266-12ESP משלה, והתקשורת מתבצעת בצורה אלחוטית באמצעות

פרוטוקול MQTT( ראה בנספחים). הרכיב כולל: תשעה הדקים דיגיטליים, הדק אנלוגי אחד, ערוץ לתקשורת UART, הדק לאפשור הרכיב והדק איפוס.

:AT24C64 (EEPROM( | זיכרון | יחידת | 9.7

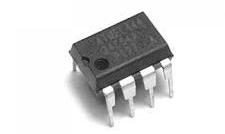
[picture p39: figure]

איור 17 - יחידת הזיכרון

רכיב זה הינו זיכרון מסוג EEPROM: רכיב זה הינו שבב אחסון מידע שלא משתנה לעתים קרובות, אשר לו שימושים במחשבים והתקנים אחרים. בניגוד ל- EPROM שבב מסוג EEPROM ניתן למחיקה ותכנות מחדש מספר פעמים באופן אלקטרוני. הוא ניתן לתכנות מספר סופי של פעמים, בדרך כלל בין 100 אלף למיליון פעמים, אך הוא ניתן לקריאה מספר בלתי מוגבל של פעמים, ויכול לשמור את הנתונים בתוכו 100 שנים. בתעשייה, ישנה מוסכמה המשמרת את מושג ה -EEPROM לזיכרונות ניתנים לכתיבה הפועל ברמה של סיביות )bitwise )ולא לזיכרונות הבזק שניתנים לכתיבה הפועלים ברמה של בלוקים ) blockwise).גודלו של זיכרון זה הוא 65536 ביט של ז י כרון טורי הניתן למחיקה ולשמירת ערכים חדשים ולקריאתם. המידע מחולק ל- 8 ביט של מילים כל אחד. זיכרון הרכיב הוא בלתי נדיף מה שאומר שלאחר כיבוי רכיב, הנתונים עדיין נשארים שמורים. רכיב זה פועל באמצעות פרוטוקול C2I( מפורט בנספחים(.

תיאור הדקי הרכיב:
)Serial Clock) SCL
הדק כניסת השעון משמשת להכניס נתון לרכיב בזמן עליית השעון ולהוציא נתון מהרכיב בזמן הירידה של השעון.
)Serial Data) SDA
זהו הדק דו כיווני להעברת נתון טורי.רגל זו היא בחיבור )drain open )ויכול להתחבר ב ORed WIRE- עם מספר נוסף של רכיבים בחיבור drain open או collector open .

)Write Protect) WP
הדק זה נותן הגנת נתונים בחומרה. הרגל מאפשרת פעולת קריאה/כתיבה רגילה כאשר היא מחוברת לאדמה. כאשר נחבר אותה ל VCC כל פעולות הכתיבה של הרביע העליון )16K bit(
של הזיכרון מעוכבים. אם חיבור WP נשאר לא מחובר, החיבור מתחבר פנימית ל- GND. בפרויקט שלנו הדק זה מחובר לאדמה.

:A0 A1 A2 DEVICE ADDRESSES ניתן לחבר עד 8 רכיבים של EEPROM תחת תקשורת C2I , לכן לכל רכיב EEPROM חייבת להיות כתובת ייחודית של עצמה. בעזרת חיבורם של הדקים הללו ל-GND או ל-VCC ניתן לקבוע את כתובתו של הרכיב כאשר 2A הוא ה-MSB ו 0A הוא ה -LSB. כתובת בר ירת המחדל של הרכיב כאשר כל ההדקים הללו מחוברים לאדמה היא 50x0 לכן אם נחבר את 2A ל- VCC, ואת 0A ו- 1A ל- GND, נקבל 4 זאת אומרת כתובת 54x.0 בפרויקט שלנו חיברנו את ההדקים הללו לאדמה כי אצלנו רק רכיב EEPROM אחד כלומר כתובת 50x.0

### 9.8 גלאי גז בישול 6MQ וגלאי עשן 135MQ:

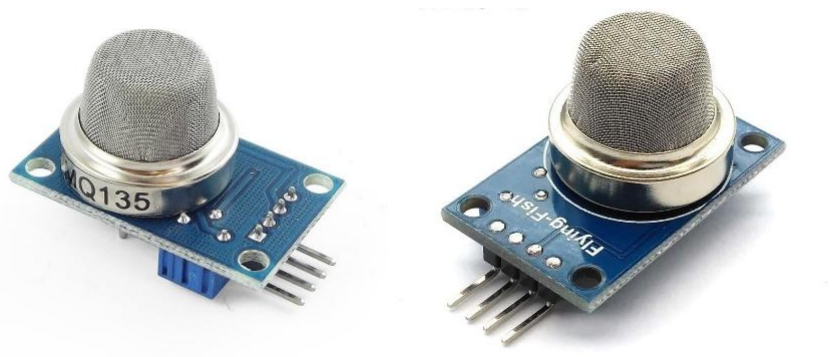
[picture p40: figure]

איור -18 חיישן גז וחיישן עשן

החומר הרגיש של החיישן גז -6MQ הוא גז בישול LPG ורגישות נמוכה לבנזין, והחומר הרגיש של גלאי 135MQ הוא עשן . במצב של אוויר נקי המוליכות היא נמוכה.

כאשר הגלאים מזהים חומר דליק המוליכות של החיישנים נעשית גבוה יותר יחד עם ריכוז הגז העולה.

לרכיבים שאנו משתמשים יש שתי יציאות, אחת אנלוגית ואחת דיגיטלית. בפרויקט שלנו אנו משתמשים ביציאה האנלוגית שתחובר לבקר 8266 ESP דרך הדק 0A( ה-D/A )כדי לקבל מידע על עוצמת הגז באוויר הבית.

### 9.9 סוללות 4LiFePO:

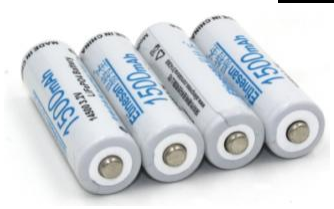
[picture p41: figure]

איור 19 - סוללות

בפרויקט אנו משתמשים בסוללות 4LiFePO נטענות של v3.2 כאשר כל כרטיס פועל בעזרת סוללות אלו, מה שמאפשר נוחות וניידות. היחידות של חיישני הגז והעשן פועלות על שני סוללות כאלו ואילו שאר יחידות החיישנים עם סוללה אחת. תחום העבודה שלהם הוא בין v-3.3v,3.2 מתח המקסימלי אותם ניתן להטעין הוא v,3.7 והמתח המינימלי אילו הן יכולות להתפרק הוא v.2.8 הסוללות האלו מקיימות פריקה קבועה, והן מבטיחות בטיחות גבוה יותר מאשר סוללות על בסיס Lithium אחרות. יתרון נוסף של סוללות אלו היא יכולת טעינה מהירה יותר, ושיעורי פריקה גבוהים יותר. בדרך כלל סוללות אלו מאפשרות מספר גבוה יותר של מחזורי טעינה מה שמאפשר חיי סוללה גבוהים יותר כשהן לא טעונות סופית. חיסרון של סוללות אלו הוא שצפיפות האנרגיה היא נמוכה יותר מאשר סוללות -LI

Ion רגילות. תוחלת החיים של סוללות אלו היא כ 5-7 שנים.

### 9.10 ממיר מתח ממותג (Up Step (BOOST:

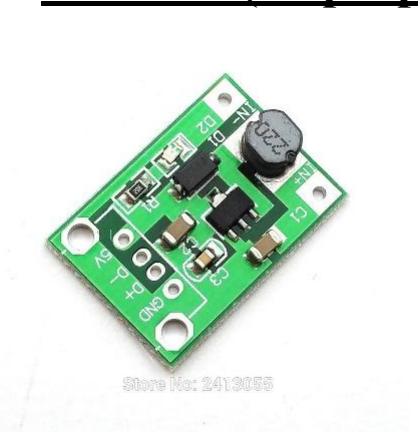
[picture p42: figure]

איור 20 - ממיר מתח ממותג

ממיר BOOST הוא ממיר המיועד להעלות מתח. ממיר זה אינו מבודד, כלומר אין הפרדה חשמלית ביו מתח הכניסה ומתח היציאה. לאחרונה פותחו לממיר זה מספר שיטות המאפשרות נצילות גבוהה מ- ,95% על ידי שימוש במעגלי תהודה להורדת הפסדי מיתוג הדיודה, ומיתוג בזרם אפס או מתח אפס כך שאין הפסדי מיתוג. מתח המוצא בדרך כלל גבוהה ולכן אין בעיה של הפסדי הולכת הדיודה. שימוש נוסף של ממיר זה הוא כמתקן גורם הספק אקטיבי. אנו משתמשים ברכיב זה רק ביחידות חיישני תנ ועה לשם הגברת מתח הסוללה מי v,3.3 למתח של v5 לשם הפעלת הרכיב.

### 9.11 חיישן טמפרטורה 20B18DS:

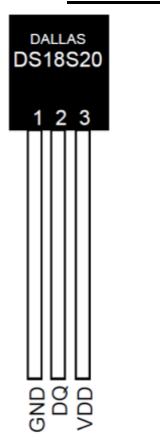
[picture p43: figure]

איור 21 - חיישן טמפרטורה

- רכיב זה מתקשר בפרוטוקול WIRE,1- משמעו שהתקשורת בין רכיב זה

למיקרובקר נעשת על ידי חוט אחד )הסבר על פרוטוקול WIRE1- בפרק 10(.

- רכיב זה אינו דורש שום רכיבים חיצוניים על מנת לתפקד.

+ ° 125 C

ל-
−° 55 C
- רכיב זה מסוגל למדוד טמפרטורה הנעה בין

± ° 0.5

- לרכיב זה ישנו רזולוציית מדידה של C
- קיימת אפשרות לחיישן זה לעבוד ללא מקור מתח חיצוני. המתח מסופק דרך 1-WIRE, נגד PULLUP דרך הדק זה כאשר הקו בגבוה. האות הגבוה גם טוען קבל פנימי )CPP), אשר מספק מתח כאשר החיישן בנמוך.

אופן פעולת הרכיב:
רכיב זה מודד את הטמפרטורה באמצעות שני מתנדי גביש פנימיים, כאשר תדר גביש אחד ) 1X )אינו מושפע מן שינויי טמפרטורה וגביש שני (2X (שתדרו מושפע מטמפרטורת הסביבה )ככל שהטמפרטורה גדלה כך גם התדר גדל( ,ותדרו גבוה משמעותית מתדר הגביש 1X.

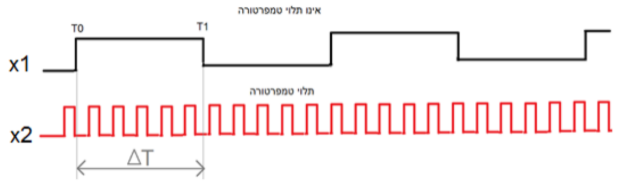
[picture p44: figure]

איור 22 - תיאור תדרי הגביש

,על ידי מדידת מספר הפולסים של הגביש 2X
ΔT

הגביש 1X מייצר חלון זמן קבוע בחלון זמן זה ולאחר כיול מקבלים מדידת הטמפרטורה.

### 9.12 פרוטוקול תקשורת WIRE-ONE:

הקדמה:
זהו פרוטוקול תקשורת טורית הנועד להעברת מידע בין מיקרובקר לבין רכיבי זיכרון וחיישנים בקו תקשורת אחד מכאן שמו WIRE ONE. קו התקשורת בינו ב- Drain Open משמעו שיש צורך בנגד Up-Pull שיתחבר בין קו המידע למתח הגבוה ) VCC), משמעות הדבר היא שהרכיבים על הקו מסוגלים רק למשוך את הקו לנמוך, דבר זה נועד כדי למנוע העמסה על הקו כאשר שני רכיבים מנסים למשוך את הקו לגבוה.

אופן שידור בקו:
איור, ניתן לראות את אופן השידור '1','0' אתחול בקו וקריאת הקו

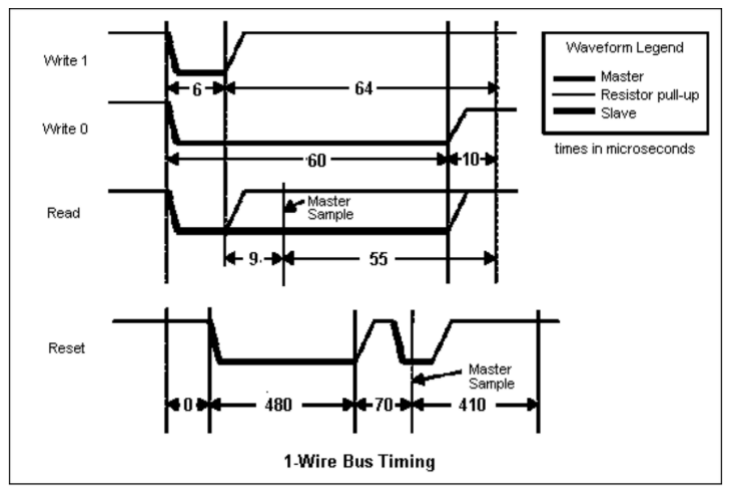
[picture p45: figure]

איור 23 - 20B18DS אופן שידור

פקודות הפעלה לרכיב 20B18DS בפרוטוקול WIRE ONE:

כל תשדורת חדשה בפרוטוקול זה מתחילה באתחול הקו )שליחת Reset).

:Read ROM [33h[
פקודה זו נותנת לרכיב ה -MASTER לקרוא את כתובת הרכיב המורכב מן 8 סיביות קודם משפחה, 48 סיביות של המספר הייחודי של הרכיב ו8- סיביות קוד CRC. פקודה זו מיועדת לשימוש כאשר רק רכיב אחד מחובר על הקו, אחרת כל הרכיבים המחוברים על הקו ינסו לענות לרכיב ה-MASTER וזה ייצור התנגשות בקו.

:Match ROM [55h[
פקודה זו כאשר אחריה מגיע כתובת הרכיב בעלת 48 סיביות מאפשרת לרכיב ה-MASTER לגשת לרכיב מסוים כאשר על הקו ישנם מספר רכיבים.

:Skip ROM [CCh[
פקודה זו יכולה לחסוך בזמן בכך ש-MASTER יכול לגשת לזיכרון הפנימי של הרכיב ללא נתינת כתובת בת 48 סיביות. פקודה זו שימושית רק במערכת עם רכיב אחד כיוון שבמערכת בעלת כמה רכיבים יכולה להיווצר התנגשות על הקו כאשר כל הרכיבים מנסים בו זמנית לשדר את המידע.

:Search ROM [F0h[
כאשר המערכת מופעלת לראשונה רכיב ה-MASTER יכול לא לדעת כמה רכיבים נמצאים על הקו או מה כתובתם בת 48 סיביות. פקודה זו נותנת לרכיב ה -MASTER להשתמש בתהליך האלימינציה כדי לזהות את כתובת בת 48 סיביות של כל הרכיבים המחוברים על הקו.

Alarm Search[ECh[
פקודה זו כמעט זהה לפקודת ROM Search אך השוני בה היא שהרכיב יענה לפקודה זו רק אם תנאי ההזעקה התמלא )האוגר בתוך זיכרון ה- EEPROM), לדוגמא אם בחיישן הטמפרטורה, הטמפרטורה המדודה גבוהה מן סף המקסימום או נמוכה מן סף המינימום.

:Write Scratchpad [4Eh[
פקודה זו מאפשרת ל- MASTER לכתוב לתוך זיכרון ה-Scratchpad של הרכיב ה-SLAVE.

:Read Scratchpad [BEh[
פקודה זו מאפשרת ל- MASTER לקרוא מן הזיכרון ה- Scratchpadשל רכיב ה-SLAVE.

:Copy Scratchpad [BEh[
פקודה זו גורמת לזיכרון ה-Scratchpad של ה-SLAVE להישמר תוך הזיכרון ה-EEPROM שלו.

:Convert T [BEh[
פקודה זו מתחילה את תהליך המרת הטמפרטורה, לאחר המרת הטמפרטורה הערך הנמדד נשמר בתוך אוגר והרכיב נכנס למצב IDLE.

### 9.13 פרוטוקול SPI:

תקן Serial Peripheral Interface "SPI "נועד לאפשר תקשורת טורית בין מכשיר

MASTER אחד למספר מכשירי SLAVE. פרוטוקול זה לא מגדיר את המידע אלא את אופן, תזמון השידור, והקליטה שלו. קצב השידור בפרוטוקול SPI הוא עד 1Mbps והמרחק המומלץ בין מכשירים הוא 3 מטר. התקן מבוסס על העברת מידע באמצעות ארבעה קווי תקשורת דו כיווניים:
- SCLK- קו שעון תזמון משותף לכל הרכיבים )נקבע על ידי ה-MASTER).
- MOSI- מידע שיוצא מ -MASTER( ארדואינו במקרה שלנו( ומגיע ל -SLAVE )המסך או ה -RFID במקרה שלנו(.
- MISO- מידע שיוצא מ-SLAVE( מסך או ה-RFID )ומגיע ל-MASTER ארדואינו.
- SS- בחירת רכיב. כשיישנם כמה רכיבים מחוברים במקביל ישנו חיבור ייחודי

לכל אחד שנקרא SELECT SLAVE( במקרה וה-MASTER מעוניין לתקשר עם רכיב מסוים, הוא שולח לאותו רכיב את הסיבית ' 0'(.

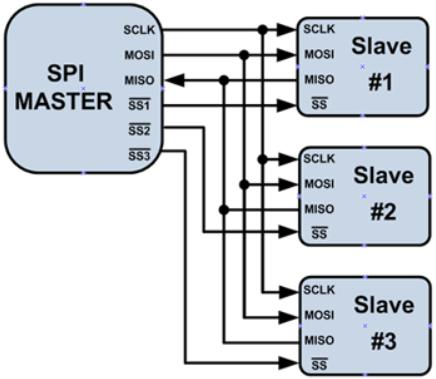
[picture p46: figure]

איור 24 - חיבור רכיבים בתקשורת SPI

תהליך התקשורת המלא מתחיל בכך שרכיב ה- MASTER מגדיר את קצב השעון ואת מצב הפעולה שלו.

קיימים ארבעה מצבי פעולה של השעון:

- מצב 0 )' 0' = CPHA,' 0= 'CPOL )- במצב זה ערך הבסיס של השעון

הוא '0' והמידע נקלט בעליית מתח. )Low to High :Edge Rising )

.)Falling Edge : Low to high ( | מתח | בירידת | ומועבר
- מצב 1 )' 1' = CPHA,' 0= 'CPOL )- במצב זה ערך הבסיס של השעון

הוא '0' והמידע נקלט בירידת מתח )Low to High :Edge Falling )

.)Rising Edge: Low to High ( | מתח | בעליית | ומועבר
- מצב 2 )' 0' = CPHA,' 1= 'CPOL )- במצב זה ערך הבסיס של השעון

הוא '1' והמידע נקלט בעליית מתח )Low to High :Edge Raising )

.)Falling Edge: Low to High( | מתח | בירידת | ומועבר
- ·מצב 3 )' 1' = CPHA,' 1= 'CPOL )- במצב זה ערך הבסיס של השעון

הוא '1' והמידע נקלט בירידת מתח )Low to High :Edge Falling )

.)Rising Edge: Low to High ( | מתח | בעליית | ומועבר

לאחר שה-MASTER קבע את מצבי הפעולה של השעון, ה-MASTER מגדיר לאיזה

SLAVE הוא עומד לבצע תקשורת באמצעות שליחת '0' בקו SS של ה-SLAVE

הרצוי. לאחר מכן, הוא שולח ביט התחלה בקו ה -MOSI שאותו ה-SLAVE קורא.

במקביל ה- SLAVE שולח ביט אישור בקו ה-MISO שאותו ה- MASTER קורא,

ולאחר מכן כאשר ה-MASTER מסיים את שליחת המידע, הוא מפסיק את פעולת השעון.
פעולה זו גורמת לביטול הבחירה של ה -SLAVE.

רק ה-SLAVE שנבחר באמצעות קו ה-CS מתייחס לשעון ה- CLK ולקו ה-MOSI,

ורק הוא יכול לכתוב מידע בקו ה- MISO. שאר רכיבי ה-SLAVE מתעלמים מהשעון

ומה- MOSI ואינם רשאים לכתוב לקו ה-MISO.

:I2C | פרוטוקול | 9.14

לארדואינו יש את היכולת לתקשר עם התקנים חיצוניים ומודולים באמצעות פרוטוקולים סטנדרטיים שהופכים את התקשורת לפשוטה ואמינה ויותר, בפרויקט שלנו השתמשנו בפרוטוקול זה לתקשורת בין הארדואינו DUE לבין זיכרון ה-EEPROM

והשעון RTC. הארכיטקטורה של C2I היא של MASTER ו- SLAVE. כשהארדואינו

הוא ה MASTER אשר מתחיל תקשורת עם רכיבים שנקראים SLAVE. מאפיינים של פרוטוקול זה:
- פרוטוקול זה דורש רק 2 חוטים לתקשורת.
- פרוטוקול זה יכול להיות יותר מסובך להפעלה מבחינת תכנות.
- פרוטוקול זה דורש שני נגדיי UP PULL על חוטי העברת המידע. כפי שציינו במאפיינים התקשורת בפרוטוקול זה נעשית באמצעות שתי חוטים: SDA - חוט זה אחראי על העברת נתונים בין הארדואינו לרכיבים אחרים. בארדואינו

DUE זהו פין .20

SCL - חוט זה הוא קו השעון האחראי לתזמון של העברת הנתונים. בארדואינו DUE זהו פין .21
כשהארדואינו מתחיל שליחת נתונים כל הרכיבים המחוברים אליו בפרוטוקול זה מקשיבים לנתונים ולכל אחד מהם מספר זיהוי ייחודי )כתובת( שמבדיל אותו מהשאר. אם התקשורת מופנית אליו הוא מגיב לתקשורת לפי הקוד ובדרך כלל שולח נתונים חזרה לארדואינו. זהו סדר הדברים:
- הארדואינו שולח ביט להתחלת תקשורת.
- הארדואינו שולח כתובת של 7 ביט שמופנית לאחד הרכיבים.
- הארדואינו שולח סיבית קריאה '0' או סיבית כתיבה ' 1' כדי להגדיר את הפעולה שברצוננו לעשות.
- הארדואינו כותב או קורא מהרכיב על ידי שליחת בית אחד אחרי השני, הרכיב מודיע שקיבל את הבית אחרי כל שליחה.
- הארדואינו שולח ביט לסגירת התקשורת.

נסביר לעומק:
העברה יכולה להתחיל רק כאשר הקו לא עסוק BUSY NOT.

בזמן העברת הנתון, קו הנתון חייב להישאר יציב כאשר קו השעון במצב גבוה. שינוי בקו הנתון כאשר קו השעון הוא גבוה יתפרש כאותות בקרה. מגדירים את מצבי הפס הבאים:

Busy Not Bus-פס לא עסוק
גם קו הנתון וגם קו השעון בגבוה.

Transfer Data Start-התחל העברת נתון

שינוי במצב קו הנתון מגבוה לנמוך כאשר השעון נמצא בגבוה מוגדר כמצב START .

Transfer Data Stop-עצור העברת נתון

שינוי במצב קו הנתון מנמוך לגבוה כאשר השעון במצב גבוה מוגדר כמצב STOP.

כל העברת נתונים מתחילה עם מצב START ומסתיימת עם מצב STOP . כמות הבתים

המועברת בין START ל STOP לא מוגבלת ונקבעת על ידי רכיב ה-MASTER, ועבור כל ביט של נתון יש פולס שעון אחד. האינפורמציה מועברת בית אחרי בית וכל רכיב קולט מאשר קבלת הבית עם ביט של ACKNOWLEDGE .

סיבית ACKNOWLEDGE:

כל רכיב קולט חייב בסיום קליטת בית, שהועבר אליו, ליצור ביט ACKNOLEDGE .

רכיב ה-MASTER יוצר פולס שעון נוסף הקשור לביט זה.

רכיב היוצר ACKNOLEDGE חייב להוריד את קו הנתון הטורי )SDA )ל0- בזמן פולס השעון, כלומר שקו הנתון יהיה יציב בנמוך בזמן שקו השעון בגבוה.

:NOT ACNOWLEDGE סיבית
סיבית זאת נשלחת במקרים הבאים:
- המקלט אינו מסוגל לקבל או לשדר כי הוא מבצע כמה פונקציות בזמן אמת והוא לא מוכן להתחיל לתקשר עם המאסטר.
- במהלך ההעברה, רכיב הקולט מקבל נתונים או פקודות שהוא אינו מבין.
- במהלך העברה , המקלט אינו יכול לקבל עוד נתונים.
- רכיב ה-MASTER סיים לקרוא את הנתונים, ומסמן זאת לרכיב ה-SLAVE.

ה-MASTER משדר וה -SLAVE קולט - אופן כתיבה- Mode Write :

תחילה רכיב ה-MASTER שולח סיבית התחלה START ומיד אחריו 7 סיביות שהינם הכתובת של ה-SLAVE וסיבית של 0 שבה ה-MASTER קובע שהוא ממשיך להכתיב ל-SLAVE.
למידע זה ה-SLAVE מחזיר סיבית ACNOWLEDGE במידה וקיבל את המידע כנדרש.
לאחר מכן ה-MASTER שולח את הכתובת שבה רוצים לשלוח את המידע ב-SLAVE. אם הכתובת גדולה מ- 255 היא תישלח בשני חלקים של 8 סיביות, לאחר כל חלק ה-SLAVE יחזיר סיבית ACKNOWLEDGE. לאחר מכן ה -MASTER שולח 8 סיביות שהם המידע ל-SLAVE, לאחר שליחת המידע ה-SLAVE יחזיר סיבית ACNOWLEDGE ומיד לאחר סיבית זו ה-MASTER יעצור את השידור עם סיבית STOP .

ה-SLAVE משדר וה- MASTER קולט -אופן קריאה- Mode Read :

תחילה רכיב ה-MASTER שולח סיבית התחלה START ומיד אחריו 7 סיביות שהינם הכתובת של ה -SLAVE וסיבית של 0 נוספת שבה ה- MASTER קובע שהוא ממשיך להכתיב ל -SLAVE.
למידע זה ה-SLAVE מחזיר סיבית ACNOWLEDGE במידה וקיבל את המידע כנדרש.
לאחר מכן ה-MASTER שולח את הכתובת שממנה רוצים לקבל את המידע מרכיב ה-SLAVE. אם הכתובת גדולה מ255- היא תישלח בשני חלקים של 8 סיביות, לאחר כל חלק ה-SLAVE יחזיר סיבית ACKNOWLEDGE. לאחר מכן ה -MASTER מתחיל שיחה מחדש ושולח סיבית START ומיד אחריו 7 סיביות שהינם הכתובת של ה-SLAVE וסיבית נוספת של 1 שבה ה- MASTER קובע שהוא מחכה למידע מה-.SLAVE
ה-SLAVE שולח סיבית ACKNOWLEDGE ולאחריה את המידע שבגודל 8 סיביות. לבסוף ה-MASTER יישלח סיבית ACKNOWLEDGE NOT לשחרר את הקו ואז יישלח סיבית STOP לעצור את השיחה.

### 9.15 פרוטוקול UART:

פרוטוקול | הוא | " UART "universal asynchronous receiver-transmitter | פרוטוקול
תקשורת טורית א -סינכרונית. בשיטה זו זמני תחילת השידור של הסיביות המרכיבות כל תו אינם קבועים מראש ואינם ניתנים לצפייה ע''י המקלט. התווים משודרים בזה אחר זה באופן בלתי תלוי כאשר מרווחי הזמן ביניהם אינם שווים בהכרח. אי לכך יש צורך להוסיף אל המידע עצמו תווי )סיביות( בקרה שונים. אנו משמשים בפרוטוקול זה לשם תקשורת בין DUE ARDUINO לבין בקר ה- 8266 ESP.

הסבר תווי/סיביות הבקרה בתקשורת טורית אסינכרונית: סיבית התחלה - Bit Start:
סיבית המסמנת את תחילת השידור, ונותנת למקלט התראה להתכונן לקליטת מידע )רמה '0'(.
תו המידע- Data:
רצף של מספר סיביות)7 או 8( שהן בעצם המידע עצמו ששודר )לדוגמא תו ASCII ) כאשר הסיבית ה LSB משודרת ראשונה וסיבית הMSB אחרונה. סיבית הזוגיות - Bit Parity: סיבית המשמשת לבקרת שגיאות. מציינת האם מס' הפעמים שבו מופיעה הסיבית ' 1' בתו מסוים )כולל סיבית הזוגיות( יהיה זוגי או אי זוגי - בהתאם למה שנקבע מראש. סיבית העצירה- Bit Stop:
מסמנת את סוף התו. סיבית זו הינה דופק ברמה לוגית ' 1' ,שמשכו שווה לזמן שידור סיבית אחת או אחת וחצי או שתיים, בהתאם לקצב השידור ולשיטת הקידוד. המצב היציב- State Steady:
רמה קבועה של ' 1' מתארת מצב ללא שידור בקו, רמה ' 1' לוגית מאפשרת בין היתר בדיקת תקינות הקו: במצב בו הקו אינו תקין הרמה הלוגית הנקלט הינה '0'.

לדוגמא:

אנו מעוניינים לשלוח את המידע 56h, בתקשורת UART:

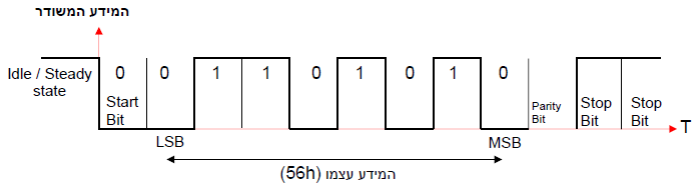
[picture p47: figure]

איור 25 - שידור 56x0 בתקשורת טורית

המשדר ומבנה התשדורת הטורית של UART: TX- רגל לשידור טורי, המידע נשלח מהתקן אחד להתקן שני ולהפך. RX-רגל קליטה טורית, המידע נקלט להתקן אחד מההתקן השני ולהפך. ההדקים הללו מחוברים בהצלבה, לכן המידע המשודר מהתקן 1 דרך הדק TX נקלט בהתקן 2 דרך הדק RX, ולהפך.

דרישות/מגבלות נוספות של תקשורת האסינכרונית:
- לא חייב להצמיד את ההודעה אחת לחברתה, אך מן ההכרח שבמסגרת הודעה אחת תהיה הצמדה מלאה של כל הסיביות-סיביות הנתונים וסיביות הבקרה )כלומר-שהסיביות לא יהיו מופרדות אחת מן השנייה כולן ברצף(.
- אין כל בזבוז זמן בהעברת הנתונים, פרט לזמן הדרוש להעברת סיביות ההתחלה וסיום עבור כל הודעה.
- מגבלה של פרוטוקול זה היא שהמקלט אינו יודע מתי המשדר יתחיל לשדר ובמערכות תקשורת מתקדמות יותר הדבר מהווה בעיה.

### 9.16 פרוטוקול MQTT:

MQTT הוא פרוטוקול להעברת מידע שעובד על עקרונות שרת/לקוח ) Server/Client )

ומפרסם /מקבל )Subscribe/Publish). הפרוטוקול הוא בעל שרת פתוח, קל לשימוש ומעוצב כדי שיהיה נוח לשימוש.

הפרמטרים האלו הופכים את הפרוטוקול לשימוש בהמון מקרים לנוח וקל, כולל סביבות מוגבלות כגון תקשורת ממכונה למכונה )M2M).

,Arlen Nipper )Arcom(-ו Andy Stanford-Clark )IBM | ( ידי | על | נוצר | MQTT-ה
Now Cirrus Link

בשנת ,1999 למטרת יצירת פרוטוקול בשביל מינימום הפסדי סוללה ומינימום רוחב פס. הם ציינו את המטרות הבאות לפרוטוקול העתידי שאמור להיות: פשוט ליישום, לספק משלוח נתונים איכותי, משקל ורוחב פס יעילים ומודעות רציפה. המטרות האלו הם עדיין הליבה של ה- MQTT.

MQTT הינו פרוטוקול העברת מידע מהתקן אחד להתקן המאפשר שיחה בין מספר

התקנים בו בזמן. בפרוטוקול זה מבוסס על מנגנון Subscribe & Publish, ה- Publish

הינו ההתקן ששולח מידע ו -Subscribe הינו ההתקן שקולט את המידע ) יש לציין שהתקן

יכול להיות גם Publish וגם Subscribe). פרוטוקול זה עובד בעזרת Broker( מתווך( אליו משודרים כל הנתונים, רק כאשר יש שינוי באחד הנתונים במתווך אז יישלח להתקן ה-Subscribe המידע החדש ששונה.

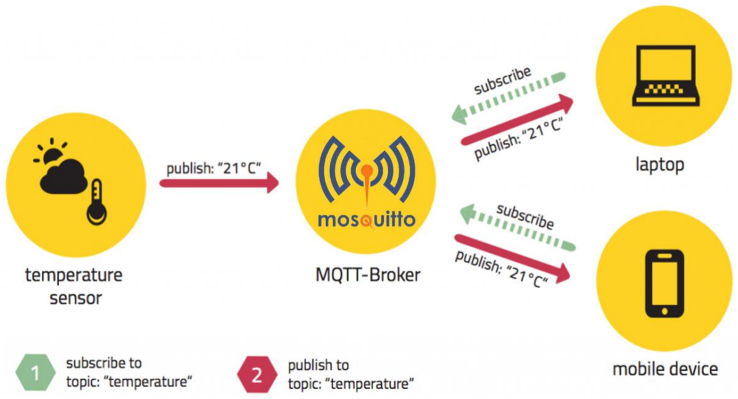
[picture p48: figure]

איור 26 - מבנה עקרוני של תקשורת

מאפיינים של פרוטוקול זה:

- מתאים לתקשורת בין הרבה נקודות שמתקשרות אחת עם השנייה דרך מתווך )Broker )במיוחד יחס של אחד לרבים
- מהיר וקל משקל, פחות בייטים נשלחים
- המכשירים לא יודעים אחד על השני
- הלקוח מתחיל תקשורת והיא נשארת פתוחה בצורה רציפה
- אידיאלי לאינטרנט של הדברים ולתקשורת בין מכונות במיוחד כשיש הרבה מהם.

ה-Broker הוא המוח של המערכת, הוא זה ששולח את המידע לכל המכשירים לפי המנוי

שעשו. ה -Broker יכול לעבד מידע במקביל ולנתב את המידע בצורה חכמה אך זו תהיה

בעיה עבור המון חיבורים. אפשר לפתור בעיה זו בעזרת חיבור צמתי Broker מקובצים המאפשרים להפיץ את העומס

לשרתים ספציפיים אשר מתמקדים באיזון העומס.

ה-Broker יכול למיין מידע על פי תחומים של נושא או עניין, תוכן או סוג לכן המשתמש יכול לקבל מידע רלוונטי על פי תחומים אלו.

ה-Client( לקוח( יכול להיות Subscribe & Publish או שניהם באותו הזמן. ה-Client יכול להיות ממיקרו בקר עד לשרת הכוללים ספריות MQTT, אשר מתחברים אל ה -Broker דרך אמצעי תקשורת כלשהוא. הספריות של ה- Client זמינות למגוון גדול של שפות תיכנות כמו אנדרואיד, ארדואינו, C, ועוד...

ה-Broker( מתווך( הוא הליבה של כל Subscribe & Publish פרוטוקול. ה-Broker יכול

להחזיק אלפים של חיבורי לקוח בו זמנית. ה -Broker אחראי בעיקר על קבלת כל ההודעות, ולהחליט מי מעוניין בקבלת המידע ולנתב את המידע ללקוח המתאים או לסנן אותם.

פרוטוקול MQTT מבוסס על IP/TCP וגם ה-Broker וה-Client צריכים להיות

מבוססים על IP/TCP

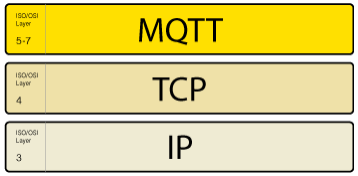
[picture p49: figure]

איור 27 - מודל 4 השכבות

החיבור תמיד מתבצע בין Client לבין ה-Broker אין אפשרות ש-Client יתחבר אל

Client אחר ישירות. החיבור מבוסס דרך שליחת הודעת CONNECT ל-Broker, וה-

Broker שולח בחזרה ל- Client הודעת CONNACK וקוד מצב. לאחר יצירת החיבור ה-

Broker ישמור אותו פתוח כל עוד הלקוח אינו שולח פקודת ניתוק או שהוא מאבד את הקשר.

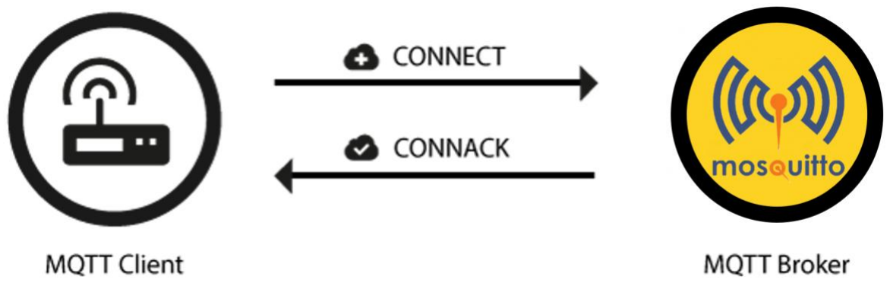
[picture p50: figure]

איור 28 - תיאור חיבור אל ה-Broker

הודעת ה -CONNECT כוללת בתוכה מאפיינים שתואמים ל-Broker, כאשר תישלח

הודעה זו ה-Broker יבדוק את התאימות, אם הודעה זו נכונה הוא יתחבר אל ה- Client

אבל אם ההודעה אינה מתאימה או שלא נשלחה במסגרת הזמן אז ה-Broker יסגור את

הקשר עם ה-Client.

בהודעה זו יש בקשה של Id Client( קיצור של Identifier Client )שבו ה- Broker מזהה

על פי הנתונים של כל Client אל איזה Client ספציפי לגשת. בנוסף בהודעה צריכים

להישלח שם משתמש וסיסמא שהוגדרו מראש ב - Broker. בשביל להתחבר ל-Broker ה -

Client צריך לשלוח בהודעה זו סיסמא ושם משתמש מסויימים, רק עם אותה סיסמא

ושם משתמש נוכל לגשת אל ה-Broker אחרת ה -Broker לא יתחבר אל ה-Client. וכך

הלאה לפי איך שהוגדר ה-Broker.

לאחר הניסיון חיבור אל ה -Broker, ה-Broker ישלח הודעת CONNACK ובה יהיה רשום תוצאות ניסוי ההתחברות, אם החיבור התבצע, נכשל או אם החיבור התנתק.

לאחר החיבור אל ה -Broker נרצה לשלוח אליו מידע, לעשות אליו Publish. בהודעת ה-

Publish יהיה חייב להיות הנושא של ההודעה ובנוסף המידע שנרצה לשלוח בפורמט של

בית )Byte).

ה-Client יקבל את הודעת ה -Subscribe כאשר התבצע שינוי, למשל עם ערך של טמפרטורה:

- אם נמדד ערך של 15 מעלות ולאחר מכן שוב 15 מעלות לא תישלח הודעה שוב אלא אם כן הטמפרטורה השתנתה מ 15 מעלות. במידה ואין שום Client שקשור לנושא של אותו

הערך אין שום צורך ב- Subscribe של הערך הנ''ל. הודעת ה-Subscribe תבוא מה -

Broker עם קוד )UNSUBACK )מסויים שדואג שהמידע יישלח רק ל -Client שקשור לנושא של הערך שהשתנה.

הנושאים ב- MQTT הם מחרוזות מסוג UTF8-( ר''ת של Transformation Unicode

8 Format )אשר משומשות על ידי ה-Broker, באמצעותם ה-Broker מנתב את המידע

לכל Client מחובר. הנושא מורכב מאחד או יותר רמות נושא )Level Topic). כל רמת נושא מופרדת בעזרת הסימן / )קו נטוי קידמי( . עדיף להימנע מלהשתמש ב / בסוף השם של הנושא האחרון מכיוון שזה מציג רמת נושא מיותרת ואין לזה יתרונות, לעתים קרובות זה רק מוביל לבלבול. בנוסף מומלץ לרשום את הנושאים קצרים ותמציתיים כי כאשר זה מוביל למכשירים קטנים כל ספירת בית מהווה הבדל.

איור 29 - תיאור הנושאים

בגלל שמשתמשים במחרוזות מסוג UTF8- יש הבדל אם נרשום

groundfloor/myhome לבין groundfloor/Myhome כי הם ייחשבו בתור 2 נושאים

שונים. כל נושא חייב להכיל לפחות אות אחת כדי שיאושר. מומלץ להימנע להשתמש ברווח בגלל שזה די ברור שיהיה קשה לנפות שגיאות של הנושאים, וזהו תו שאינו מוכר מפני שב UTF8- מכיר המון סוגים של רווח.

ישנם תווים כללים שאם הם מופיעים ב -Client בנושא אז יישלחו אליהם מספר תווים או יותר. יש 2 רמות של תווים כלליים: רמה אחת ורמה מרובה. רמה אחת מסומנת ע'' י הסימן + ורמה מרובה ב .# נסביר את הרמות באמצעות מספר דוגמאות -

ניקח דוגמה עבור רמה אחת של נושא temperature/+/groundfloor/myhome

כל הנושאים שבהתחלה שלהם יש את groundfloor/myhome ובסוף / temperature זאת אומרת לא משנה מה יהיה רשום בתת נושא במקום ה+ יישלחו ל-Client. לדוגמה אם קיימים הנושאים הבאים הם יישלחו ל -Client:

myhome/groundfloor/center/temperature

myhome/groundfloor/kitchen/temperature

myhome/groundfloor/parentsroom/temperature

ניקח דוגמה עבור רמה מרובה של נושא /# groundfloor/myhome

כל הנושאים שלהם יש את אותה ההתחלה לא משנה מה הסוף שלהם יישלחו

ל-Client. זאת אומרת שגם עבור המקרה הזה הדוגמאות שנרשמו מקודם גם יישלחו כי

להם יש את אותה התחלה של נושא. אם יש המון נושאים עדיף לא לעשות Subscribe לכולם כי אחרת ההודעה תהיה מעל המותר ולא יוצגו כמו שצריך.

בנוסף יש נושאים מיוחדים שמטופלים באמצעות ה-Broker שנשמרים בתוך האחסון

הסטטיסטי הפנימי של ה-Broker. נושאים אלו מתחילים עם הסימן $ אך לרוב

מתחילים ב -SYS.$ לנושאים אלו לא ניתן לעשות Publish מה-Client, רק ה- Broker אחראי עליו.

שם של נושא לדוגמה:sent/messages/broker/SYS$

ל-MQTT יש 3 רמות של איכות שירות )QoS )Service of Qulity. זו היא הסכמה בין הנשלח לנקלט של ההודעה לגבי האחריות של שליחת ההודעה. אלה הם שלושת הרמות שירות:

Exactly Once -ו 1-כ גם | מסומן | At Least Once ,0 כ גם | מסומן | At Most Once
שמסומן גם כ .2-

יש שני חלקים של שליחת הודעה: ה-Publish מה-Client אל ה- Broker והשני הוא ה-

Subscribe מה -Broker אל ה-Client. צריכים להסתכל על 2 מקרים אלו בנפרד כי יש

הבדלים מתוחכמים ביניהם. איכות השירות עבור Publish מה -Client אל ה-Broker

תלוי ברמת האיכות של ה-Client שנקבעה בשביל ההודעה. עבור מקרה שה-Broker

שולח הודעת Subscribe עבור אחד ה-Client איכות השידור נקבעה מבעוד מועד.

איכות השירות זו היא תכונה מרכזית של ה-MQTT, זה מאפשר שיחה יעילה וקלה בין רשתות לא ברורות או לא אמינות, מכיוון שהפרוטוקול מטפל ומבטיח אחריות לשידור הודעה, ללא קשר לכמה השרת הוא לא אמין או לא ברור. כמו כן, הוא מעצים את ה -Client לבחור את רמת איכות השירות בהתאם לאמינות הרשת וללוגיקת היישום.

איכות שירות 0 )QoS 0 )

הרמה המינימלית היא רמת ,0 היא מבטיחה את השליחה הכי טובה. ההודעה לא תוחזק על ידי המקלט או תהיה מאוחסנת או תשלח מחדש על ידי השולח. לרוב לרמה זאת קוראים בשם "תירה ותשכח" ומספקת את אותם הבטחות כמו הפרוטוקול TCP הבסיסי.

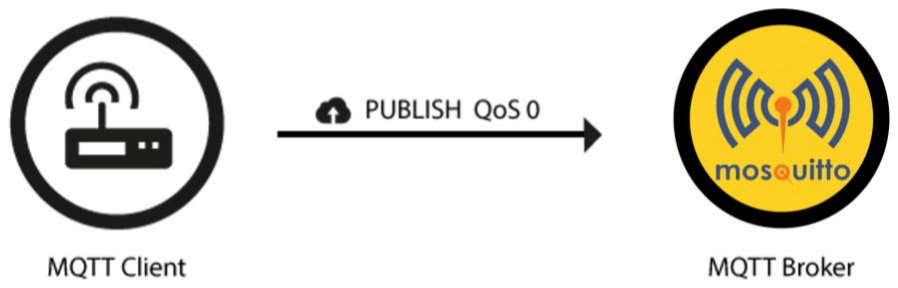
[picture p51: figure]

איור 30 - תיאור איכות שירות 0
איכות שירות 1 )QoS 1 )

רמה איכות שירות זו מבטיחה תישלח לפחות פעם אחת למקלט אך יכול להיות שההודעה יכולה להישלח יותר מפעם אחת. השולח יאחסן את ההודעה עד שהוא יקבל אישור בפקודת PUBACK מהשולח.

ה-PUBACK זוהי חבילה המגיבה לחבילת ה -Publish עם QoS .1

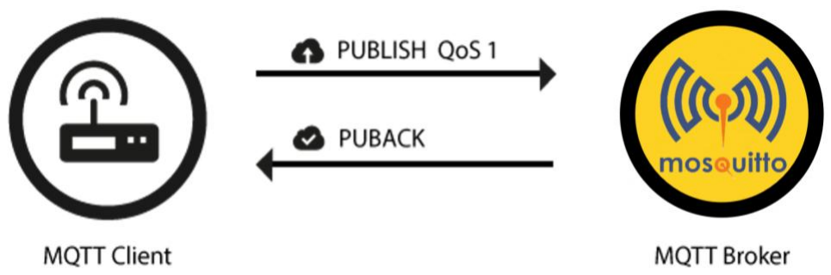
[picture p52: figure]

איור 31 - איכות שירות 1

איכות שירות 2 )2 QoS )

זו היא הרמה הגבוהה ביותר, המבטיחה שכל הודעה תקלט פעם אחת. זו היא רמת איכות השידור האטית ביותר והבטוחה ביותר. האחריות מובטחת בין שני הצדדים בין השולח למקלט.

במקרה זה השולח ישלח PUBLISH 2 QoS( זו היא החבילה הראשונה( המקלט יעבד

את המידע ובהתאם לכך המקלט ישלח הודעת PUBREC( החבילה השנייה( שזו היא

חבילת תגובה עבור הודעת PUBLISH.

המשדר ישמור את הודעת התייחסות PUBREC בחבילות הזיהוי עד שיישלח הודעת

PUBCOMP, זה חשוב כדי למנוע מלעבד את ההודעה פעם שנייה. כאשר השולח מקבל

את הודעת ה-PUBREC הוא יכול בבטחה לזרוק את הודעת ה-Publish כי הוא יודע אם המקלט קיבל בהצלחה את ההודעה.

המשדר יאחסן את הודעת ה- PUBREC ויגיב עם הודעת PUBREL( זו היא החבילה

השלישית(. אחרי שהמקלט יקבל את הודעת ה-PUBREL הוא יכול למחוק כל מצב

מאוחסן ולהגיב עם PUBCOMP( זו היא החבילה הרביעית והאחרונה( הדבר גם נכון

אם השולח יקבל את הודעת ה-PUBCOMP. לאחר שכל השיחה הושלמה שני הצדדים יכולים להיות בטוחים שההודעה נשלחה והשולח יודע על כך. בכל פעם שהמשלוח הולך לאיבוד בדרך השולח אחראי על שליחת ההודעה האחרונה לאחר פרק זמן סביר. זה נכון כאשר השולח הוא ה -Client וגם כש -Broker שולח הודעה.

על הצד המקבל מוטלת האחריות להגיב על כל הודעת פקודה בהתאם למה שקיבלה.

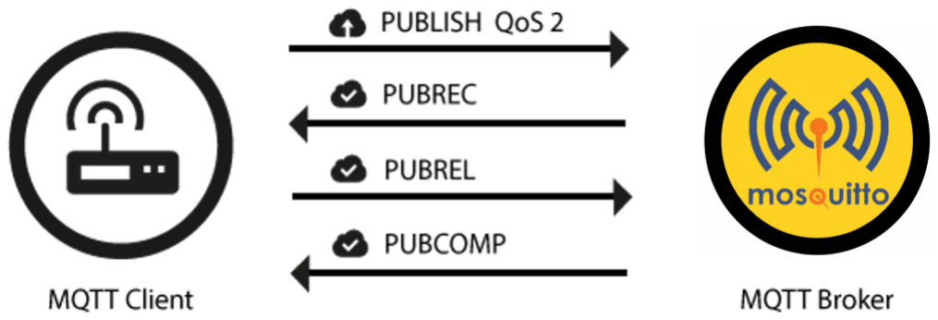
[picture p53: figure]

איור 32 - איכות שירות 2

מתי משתמשים ברמת שירות 0

.1 כאשר קיים חיבור יציב או כמעט יציב בין השולח לקולט

.2כאשר לא אכפת אם אחד או יותר הודעות אבדו לפחות פעם אחת.

.3כאשר אין הודעות הנמצאות בתור לשליחה או לקבלה.

מתי משתמשים ברמת שירות 1

.1 כאשר חייבים לקבל את כל ההודעות, וכאשר מטרת השימוש תוכל להתמודד עם כפילויות.

.2כאשר לא ניתן לשאת מעל רמת שירות .2 כמובן שרמת שירות 1 היא הרבה יותר מהירה בשליחת ההודעות ללא האחריות של רמה .2

מתי משתמשים ברמת שירות 2

כאשר זה ממש חשוב לקבל את כל ההודעות פעם אחת, מכיוון שלעתים קרובות הכפילויות יכולות לגרום לפגיעה ביישום או ל-Clients אשר ב -Subscribe.

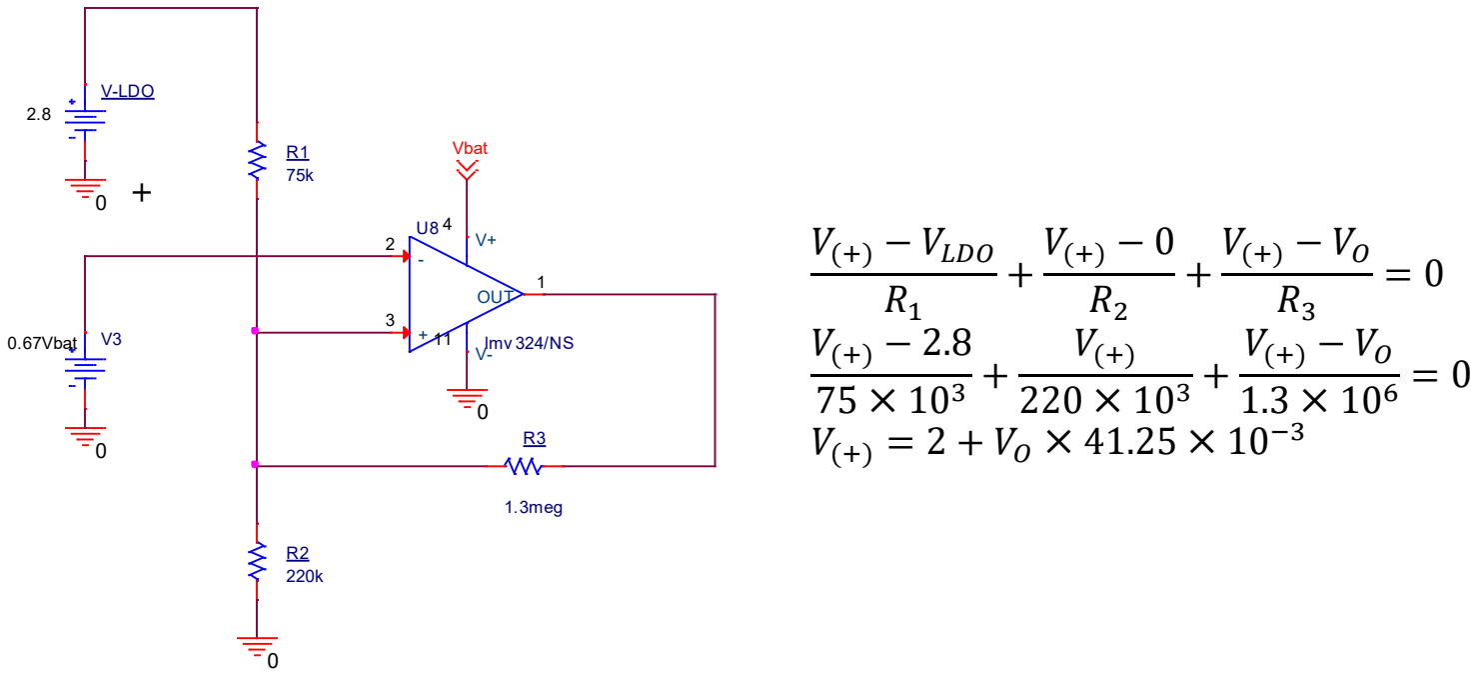
[picture p54: figure]
V(+) − VLDO R1; V-LDO; Vbat; 0.67Vbat; lmv 324/NS +; OUT; 1.3meg

איור 33 - שרטוט השמיט ממעגל המיתוג האלקטרוני שבאיור 3.6

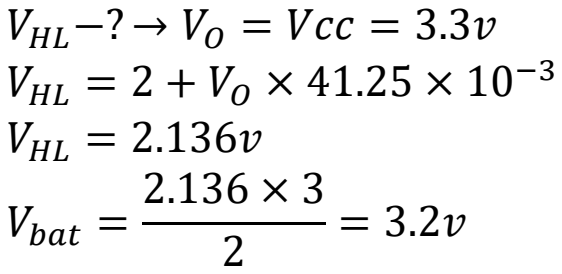
[picture p55: figure]
VHL−? → VO = Vcc = 3.3v VHL = 2 + VO × 41.25 × 10; VHL = 2.136v; Vbat =
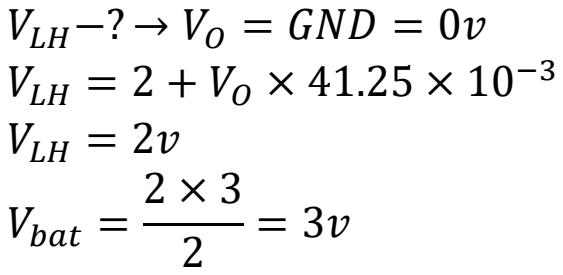
[picture p56: figure]
VLH−? → VO = GND = 0v VLH = 2 + VO × 41.25 × 10; VLH = 2v; Vbat =
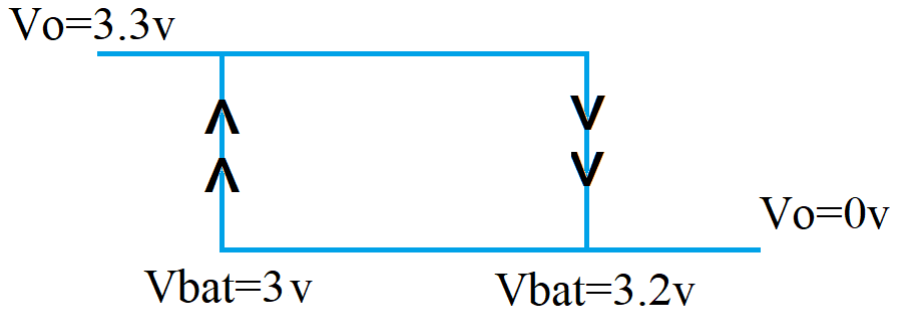
[picture p57: figure]

איור 34 - רוחב החשל

### פרק חישובים:

חישוב רוחב החשל של השמיט במעגלי היחידות של החיישנים הספרתיים:

חישוב אחוזי החיישני גז בישול ועשן:

מתח המוצא המקסימלי של חיישנים אלו הוא v3.8 והמינימאלי הוא v0

החיסרון של 8266ESP הוא שהדק 0A יכול לקלוט עד v1.1 לכן למוצא החיישן חיברנו מחלק מתח שיקטין את האות ביחס קבוע.

מתח של v3.8 הוקטן ל - v,1 אם יתקבל מתח זה במבוא ה- 8266ESP אז הוא יקבל את הערך 930

R =

1.1
1024

D =

V
R

=

1 × 1024
1.1

= 930

אם קיבלנו ערך זה עבור מתח מקסימלי שבמוצא החיישן אז 930 שווה ערך ל100%-

לכן:

= הערך באחוזים

הערך שהתקבל
930 × 100

חישוב אחוזי הסוללה:

מתח הסוללה המקסימאלי מגיע עד v3.7 ה 8266-ESP פועל החל ממתח של v3 לכן ניקח את v3 בתור מתח מינימלי

החיסרון של 8266ESP הוא שהדק 0A יכול לקלוט עד v1.1 לכן למוצא החיישן חיברנו מחלק מתח שיקטין את האות ביחס קבוע.

מתח של v3.7 הוקטן ל v1

אם יתקבל מתח זה במבוא ה 8266-ESP אז הוא יקבל את הערך 930

R =

1.1
1024

D =

V
R

=

1 × 1024
1.1

= 930

מתח של v3 הוקטן לv0.81

אם יתקבל מתח זה במבוא ה 8266-ESP אז הוא יקבל את הערך 754

R =

1.1
1024

D =

V
R

=

0.81 × 1024
1.1

= 754

אם 930 מסמל 100% והערך 754 מסמל 0% אז

= הערך באחוזים

754 − הערך שהתקבל
930 − 754 × 100 =

754 − הערך שהתקבל
176

חישוב ערך הנגד שמחובר אל הדיודת זנר ביחידות חיישני הגז בישול והעשן:

בחיישנים אלו יש גוף חימום פנימי שהערך התנגדות החימום הוא Ω33 ( על פי דף יצרן( בהתחשב שמחוברים במקביל אל הזנר גם שאר המעגל נגיד וערך ההתנגדות במקביל לזנר הוא Ω.28 הזרם על עומס זה הוא:

5.1 182.14
28

Z

L

V
I | mA
R
= | = | =

הזנר צריכה בנוסף זרם של mA49( על פי דף יצרן( לכן הזרם על הנגד הוא סכום שני הזרמים.

אל המעגל צריכים להיות מחוברים לפחות 2 סוללות של 4LiFePO שהמתח העבודה של הסוללה נע בין v-3.3v3.2 .

לכן ערך ההתנגדות של הנגד צריכה להיות:

R =

2 × VBat − Vz
IR

=

6.6 − 5.1
| | 231 × 10

−3 = 6.5Ω

אנו לקחנו נגד בקירוב בערך של Ω.5
