Alon-Tal/WiFi-Alarm/(list of files, drawings)

Other design files:
OrCAD Schematic/WIFI_ALARM.DSN
